EngAdriano/Aquabox_Final/hardware/Ideia_PCB.png

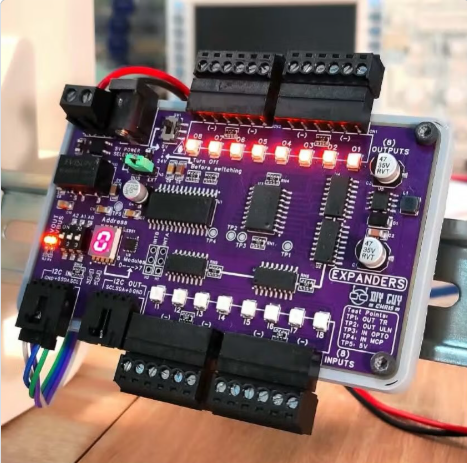
hardware/Ideia_PCB.png
