EngAdriano/Aquabox_Final/exemplos/AcioanamentoRele.jpg

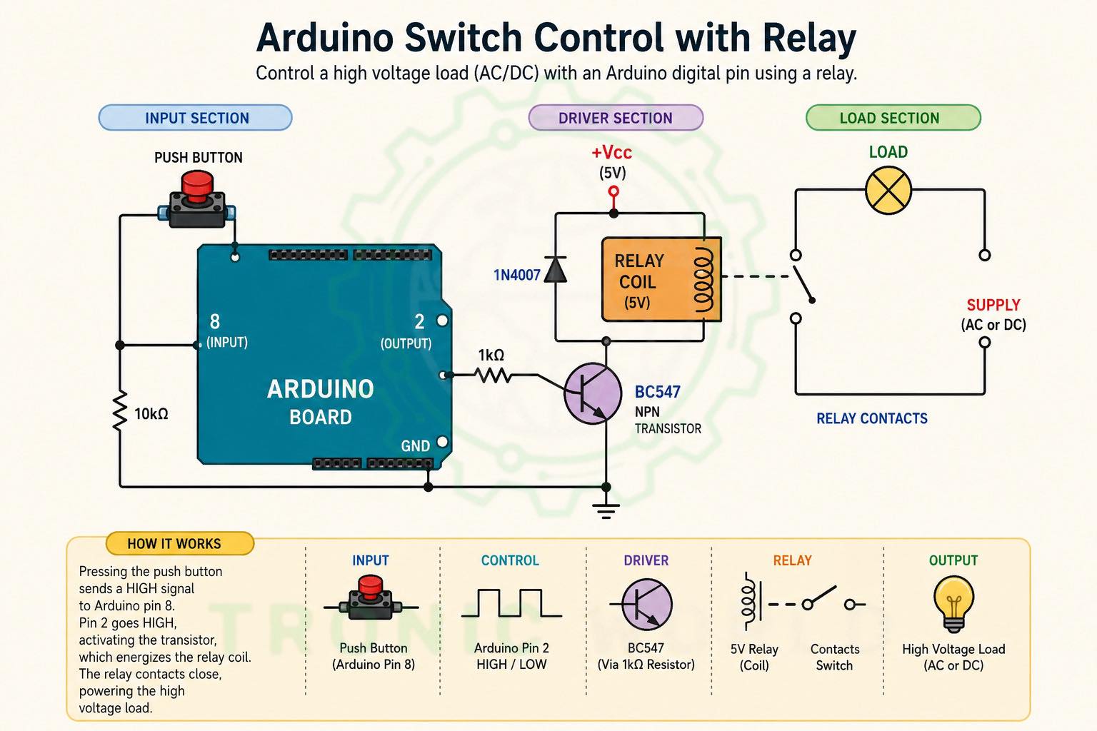
exemplos/AcioanamentoRele.jpg
