EngAdriano/Aquabox_Final/README.md

# Aquabox_Final
Repositório para o desenvolvimento do projeto Aquabox versão final.
