EngAdriano/Aquabox_Final/Planejamento/Respostas_Decisoes_Pendentes.docx

AQUABOX

Planejamento de Requisitos do Firmware

12. Decisões pendentes para a próxima revisão - Respostas:

12.1 - Definir características elétricas e lógica ativa dos sensores de nível, chaves, relé e drivers de solenoide (ativo alto/baixo, pull-up/pull-down e isolamento).

R. Planilha com todos os dados necessários:

12.2 - Definir limites configuráveis: duração máxima de irrigação, timeout de enchimento, janela de atraso, debounce e faixas da vazão esperada.

R.

- Duração máxima de irrigação: 60 minutos por setor (solenoide);
- Timeout de enchimento: 10 minutos;
- Janela de atraso: 5 minutos entre setores;
- Debounce: implementado em hardware;
- Faixa de vazão esperada: configurada pois depende da rede hidráulica.

12.3 - Confirmar se a irrigação terá dias da semana, múltiplos horários por canal e regras para pular ciclos em caso de falta de água.

R. A Irrigação poderá ser configurada se será ativa por dia da semana, poderá ser configurado para pelo menos dois horários do dia por canal, em caso de falta de água alertar e esperar a normalização para ser acionada.

12.4 - Definir comportamento da chave de bomba independente: somente solicitação manual com válvula aberta ou operação de teste com regra adicional.

R. A Chave da bomba será utilizada para acionamento da mesma em caso de necessidade de água para outras atividades. Não será necessário acionamento de válvula solenoide pois terá uma conexão própria para tal atividade.

12.5 - Definir retenção de configuração e de histórico, além da necessidade de bateria no RTC e política para horário inválido.

R.: As configurações deverão ser armazenadas em memória para não serem perdidas com falta de energia. O histórico pode ser armazenado em memória que vem com o módulo RTC que será alimentada por uma bateria, assim com falta de energia não perderá o relógio nem o conteúdo da memória AT24C32 que vem nele.

12.6 - Definir broker MQTT, política de credenciais, uso obrigatório de TLS, certificado de autoridade e processo de provisionamento Wi-Fi.

R. Vamos utilizar o broker HiveMQ, vamos criar credenciais para cada Aquabox que for instalado. Inicialmente teremos dois.

12.7 - Definir permissões de comando remoto por perfil/usuário, retenção de telemetria e integração prevista com painel ou aplicativo.

R. Gostaria que você definisse a melhor política para esses casos.

12.8 - Definir orçamento de CPU, tamanho de pilha, prioridades e afinidade definitiva de cada tarefa FreeRTOS após prototipação com Wi-Fi e display reais.

R. Foi montado um protótipo para acompanhar o desenvolvimento do firmware, ele está baseado na planilha do item 12.1, assim vamos evoluir de acordo com os testes e necessidade. A nossa CPU será a ESP32-S3 DevKitC-1 8MB PSRAM 16MB FLASH N16R8 Dual type-C 44P.

12.9 - Validar requisitos de proteção elétrica, caixa, grau de proteção ambiental e normas aplicáveis ao conjunto.

R. Ao concluirmos o firmware no protótipo, passaremos para a etapa de desenvolvimento da placa PCB e todos os detalhes para a montagem em caixa própria e proteções, se bem que o sistema já vai contar com várias proteções como fontes isoladas, optoacopladores com alimentações isoladas, entre outras.

Documento de trabalho - Firmware Aquabox

AQUABOX | PLANEJAMENTO DE REQUISITOS
