EngAdriano/Aquabox_Final/firmware/Pinagem_ESP32_S3.pdf

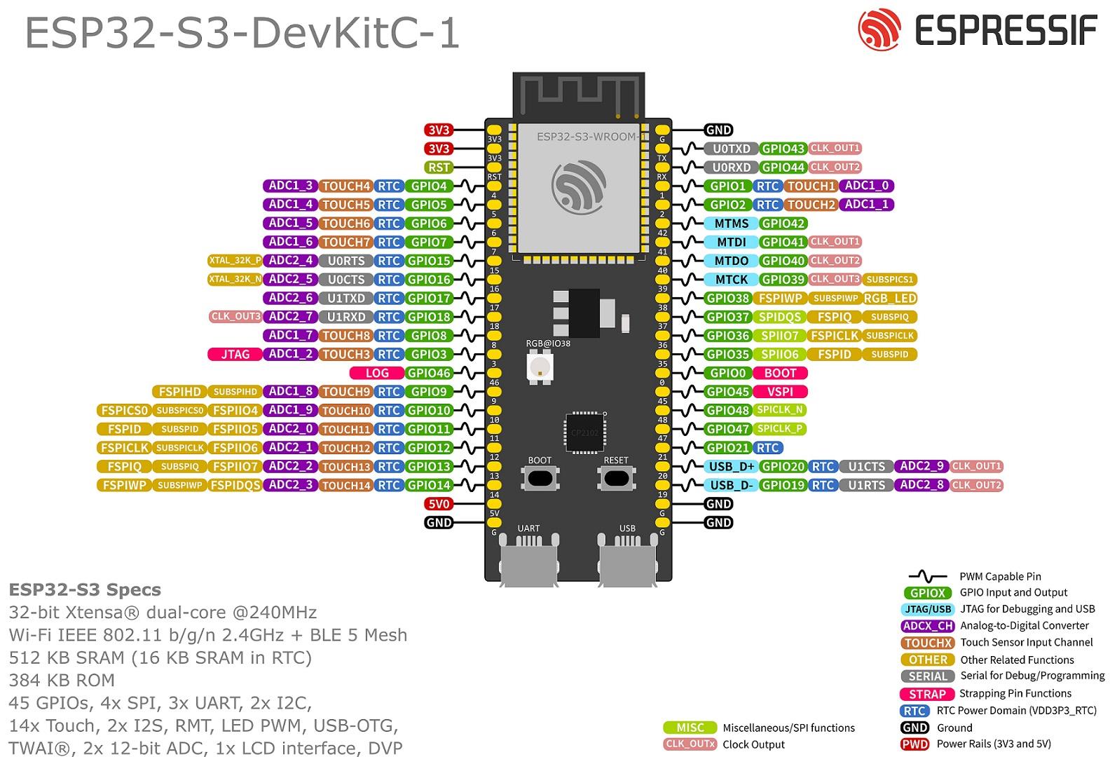
[picture p3: page 1]
