EngAdriano/Aquabox_Final/hardware/Lista_de_Componentes.pdf

Reference | Qty Value | Footprint
BT1 | 1 | Battery_Cell | Battery:Battery_Panasonic_CR2032-HFN_Horizontal_CircularHoles
C1 | 1 | 0.1uFx275V
C2 | 1 | 220uF
C3,C4,C5,C6,C7,C8,C9,C10,C11 | 9 | 100n
D1,D2 | 2 | RED
D3,D4,D5,D6,D7,D8,D9,D10 | 8 | LED
D11 | 1 | 1N4007 | Diode_THT:D_DO-41_SOD81_P10.16mm_Horizontal
F1 | 1 | 1A 250V
J1 | 1 | Entrada de 12V
J2 | 1 | AC 220V
J3 | 1 | Caixa_1
J4 | 1 | Caixa_2
J5 | 1 | Caixa_3
J6 | 1 | Sensor de Fluxo
J7 | 1 | Screw_Terminal_01x04
J8 | 1 | Conn_01x03
J9 | 1 | Conn_01x05
J10 | 1 | Conn_01x10
K1 | 1 | Relay_SPDT
PS1 | 1 | MC00100 | MC00100:CONV_MC00100
Q1,Q3,Q5,Q10 | 4 | BC337 | Package_TO_SOT_THT:TO-92_Inline
Q2,Q4,Q6 | 3 | BC327 | Package_TO_SOT_THT:TO-92_Inline
Q7,Q8,Q9 | 3 | IRLZ44N | Package_TO_SOT_THT:TO-220-3_Vertical
R1,R7,R8,R9,R10,R13,R14,R15,R16,R19,R20,R21,R22,R23,R28,R29,R30,R41 | 18 1K
R2 | 1 | 1M
R3,R25,R40,R42 | 4 | 220R
R4,R5,R6 | 3 | 4K7
R11,R12,R17,R18,R24,R26,R27,R31,R32,R33,R37,R38,R39,R43,R44,R45,R46,R47,R48,R49,R50,R51,R52,R53,R54 | 25 10K
R34,R35,R36 | 3 | 10R
RV1 | 1 | 10D561K
U1 | 1 | HLK-10M05 | Converter_ACDC:Converter_ACDC_Hi-Link_HLK-10Mxx
U2 | 1 | ESP32-S3-DEVKITC-1-N16R8V | ESP32-S3-DEVKITC-1-N16R8V:XCVR_ESP32-S3-DEVKITC-1-N16R8V
U3 | 1 | DS3231M | Package_SO:SOIC-16W_7.5x10.3mm_P1.27mm
U4,U5,U6,U7,U8,U9,U10,U11,U12,U13,U14 | 11 PC817 | Package_DIP:DIP-4_W7.62mm
U15 | 1 | 74HC14
