EngAdriano/Aquabox_Final/modelos/Conect_2_10/Conect_2x10.step

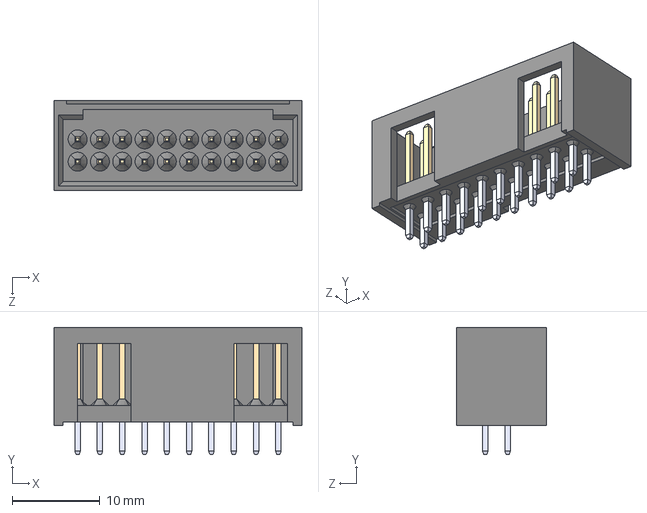
[picture p4: CAD file, 2026-06-03]
modelos/Conect_2_10/Conect_2x10.step
28.2 x 14.5 x 10.3 mm
