EngAdriano/Aquabox_Final/modelos/ESP32-S3-DEVKITC-1-N16R8V/ESP32-S3-DEVKITC-1-N16R8V.step

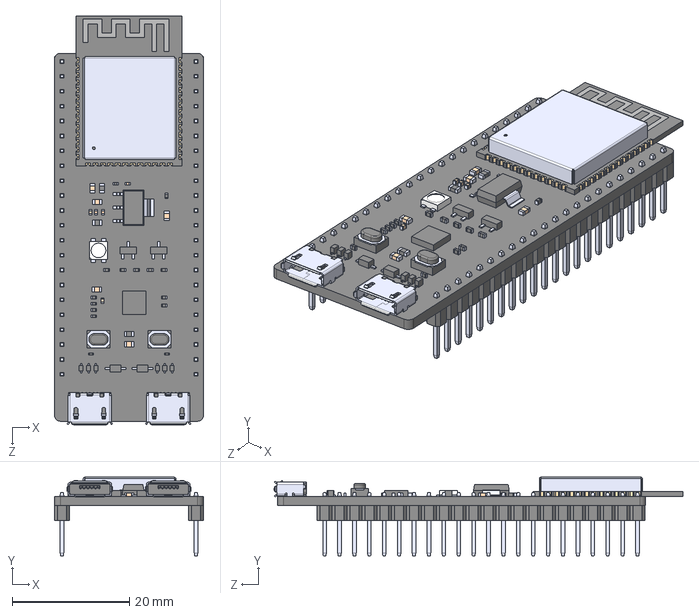
[picture p5: CAD file, 2026-05-29]
modelos/ESP32-S3-DEVKITC-1-N16R8V/ESP32-S3-DEVKITC-1-N16R8V.step
25.4 x 13.4 x 69.6 mm
