EngAdriano/Aquabox_Final/modelos/Conect_2x5/5104338-1.step

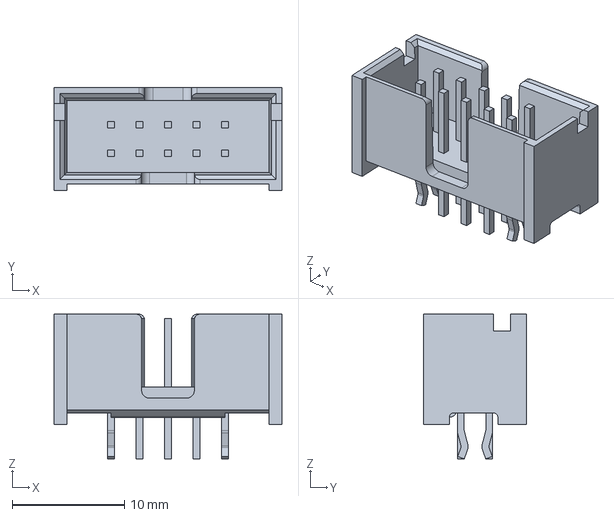
[picture p6: CAD file, 2026-06-03]
modelos/Conect_2x5/5104338-1.step
20.3 x 9.14 x 12.9 mm
