EngAdriano/Aquabox_Final/modelos/MC00100/MC00100.step

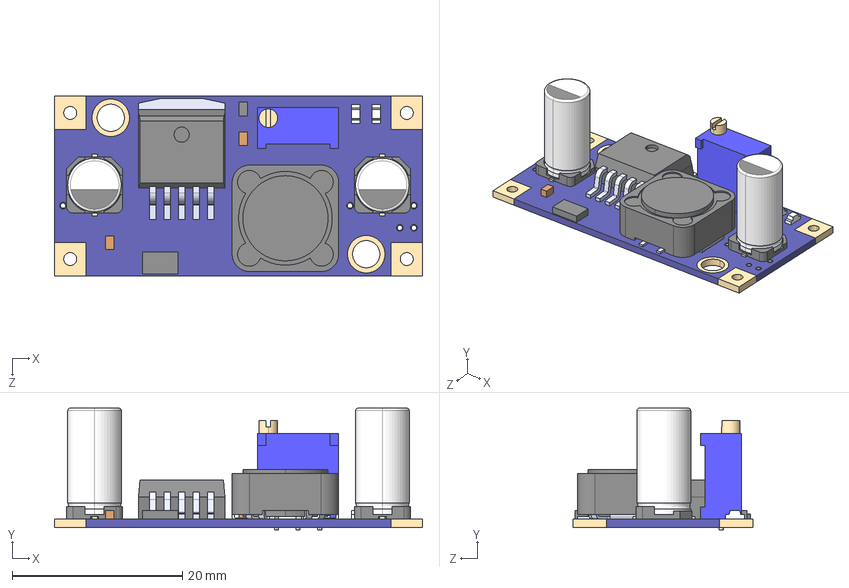
[picture p7: CAD file, 2026-06-02]
modelos/MC00100/MC00100.step
43.2 x 14.3 x 21.1 mm
MC00100
3296W-1-104
DR125-331-R
LM2596DSADJG
EEE1HA470XAP x 2
