EngAdriano/Aquabox_Final/exemplos/Acitivity-Tracker-Schematic.pdf

` | `

# Battery Charger

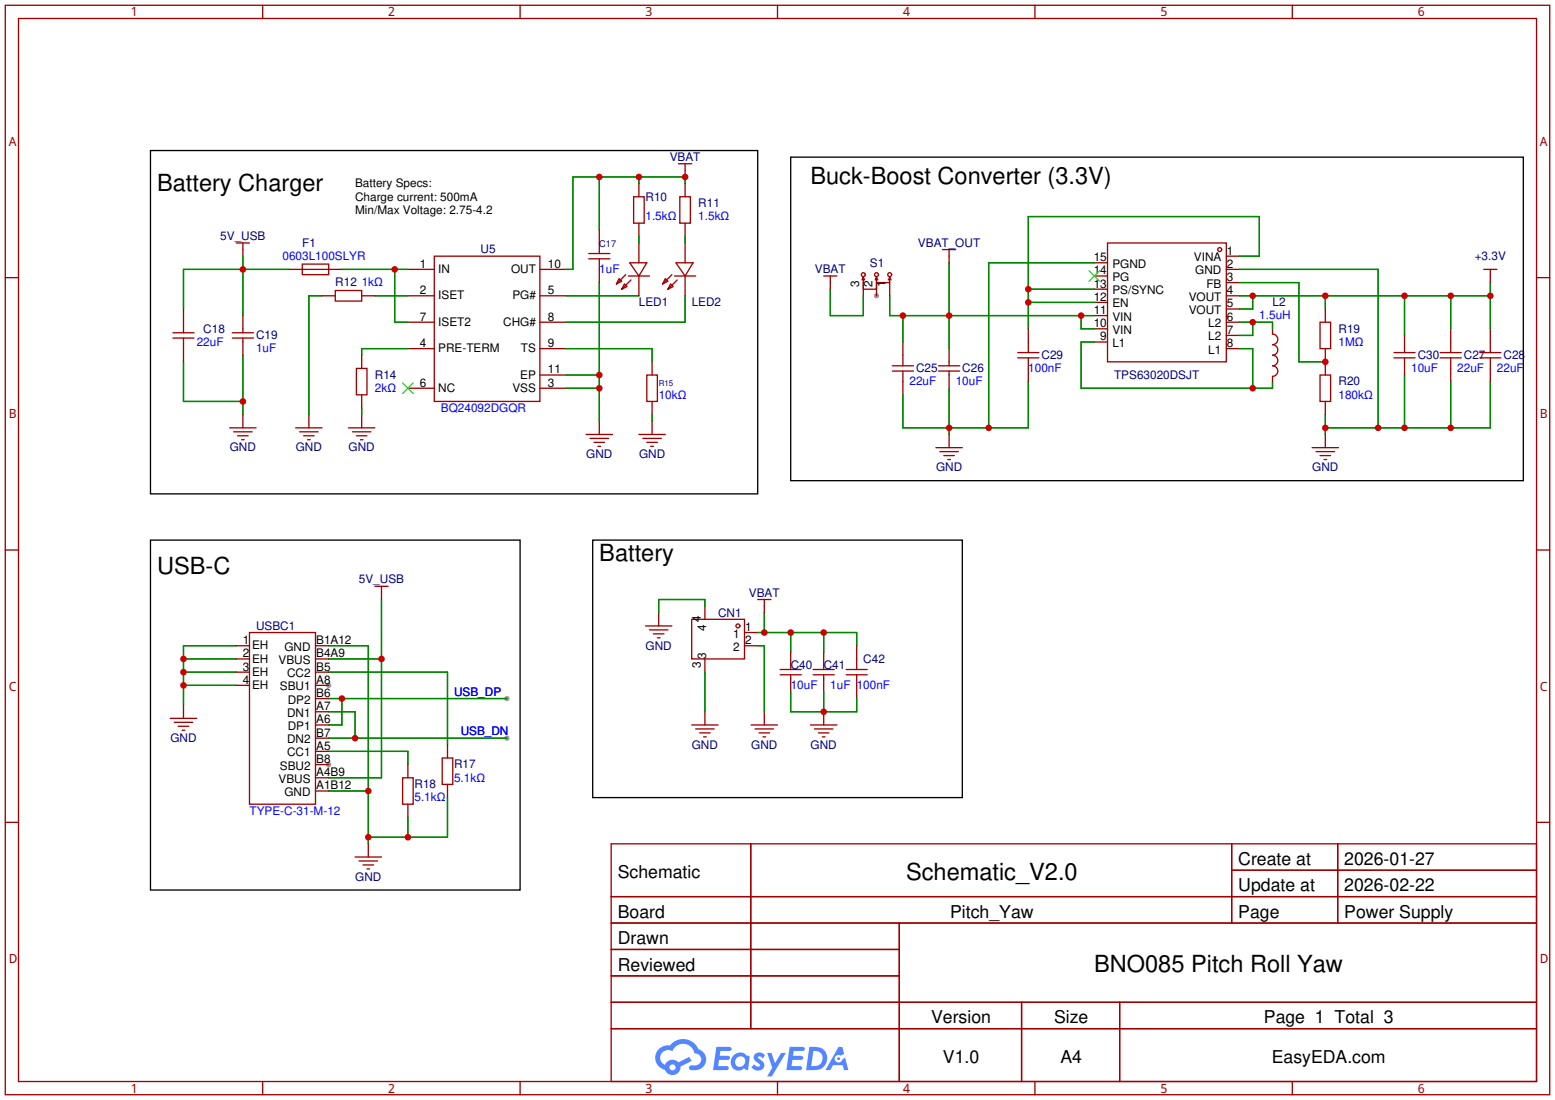
[picture p8: page 1]

VIN 10 VIN 11 EN 12 PS/SYNC 13 PG 14 PGND 15

USB-C
GND A1B12 VBUS A4B9 SBU2 B8 CC1 A5 DN2 B7 DP1 A6 DN1 A7 DP2 B6 SBU1 A8 CC2 B5 VBUS B4A9 GND B1A12

Schematic | Schematic_V2.0 | Create at | 2026-01-27

Update at | 2026-02-22

Board | Pitch_Yaw | Page | Power Supply
Drawn | | BNO085 Pitch Roll Yaw
Reviewed

Version | Size | Page 1 Total 3

V1.0 | A4 | EasyEDA.com

` | `
IO0 27 IO35 28 IO36 29 IO37 30 IO38 31 IO39 32 IO40 33 IO41 34 IO42 35 RXD0 36 TXD0 37 IO2 38 IO1 39 GND 40

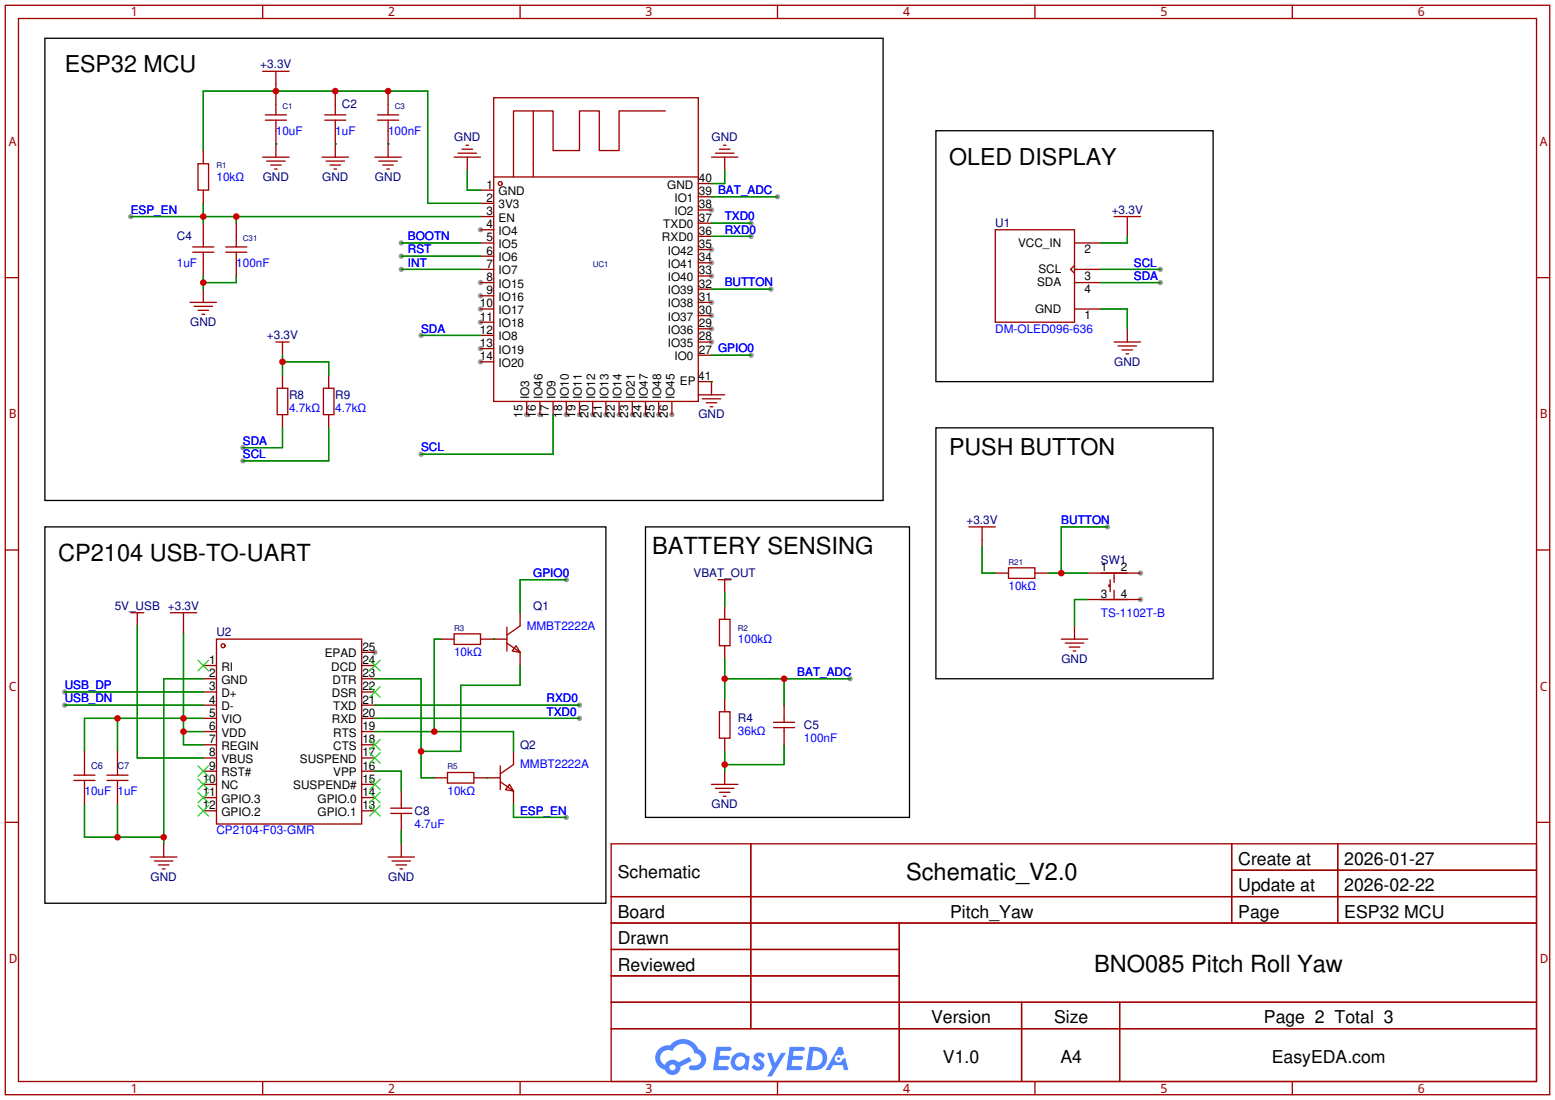
[picture p9: page 2]

Schematic | Schematic_V2.0 | Create at | 2026-01-27

Update at | 2026-02-22

Board | Pitch_Yaw | Page | ESP32 MCU
Drawn | | BNO085 Pitch Roll Yaw
Reviewed

` | `

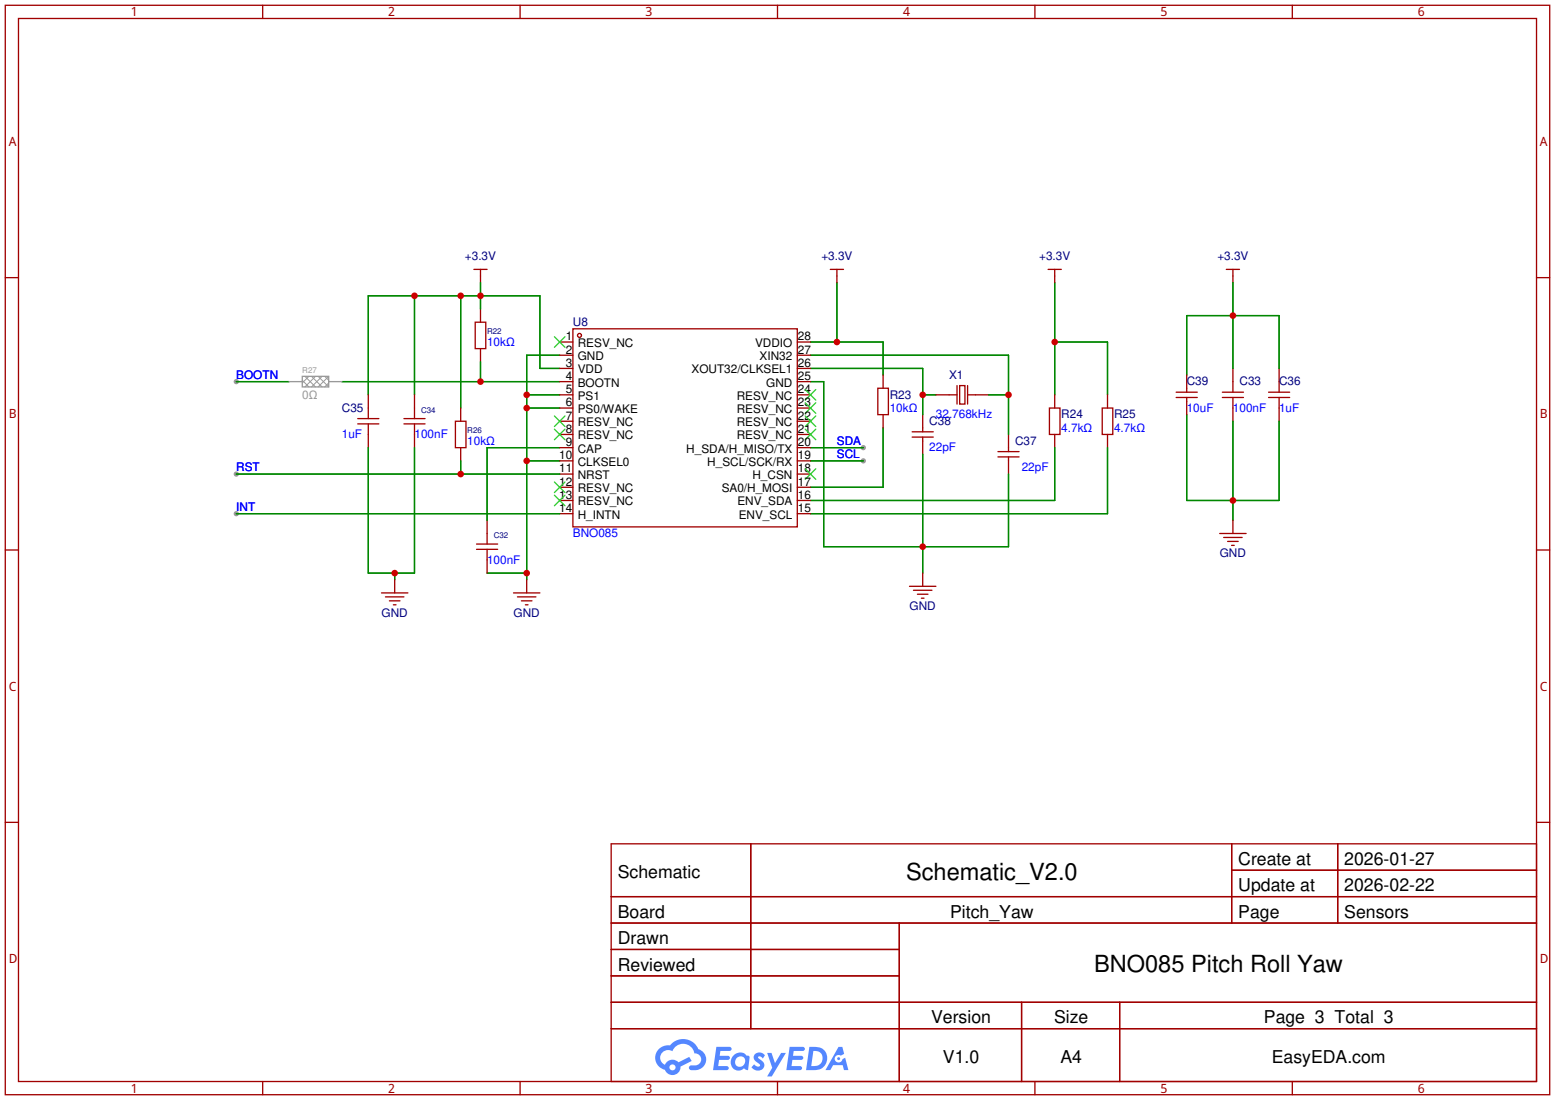
[picture p10: page 3]

Schematic | Schematic_V2.0 | Create at | 2026-01-27

Update at | 2026-02-22

Board | Pitch_Yaw | Page | Sensors
Drawn | | BNO085 Pitch Roll Yaw
Reviewed
