EngAdriano/Aquabox_Final/hardware/aquabox_final/aquabox_final.pdf

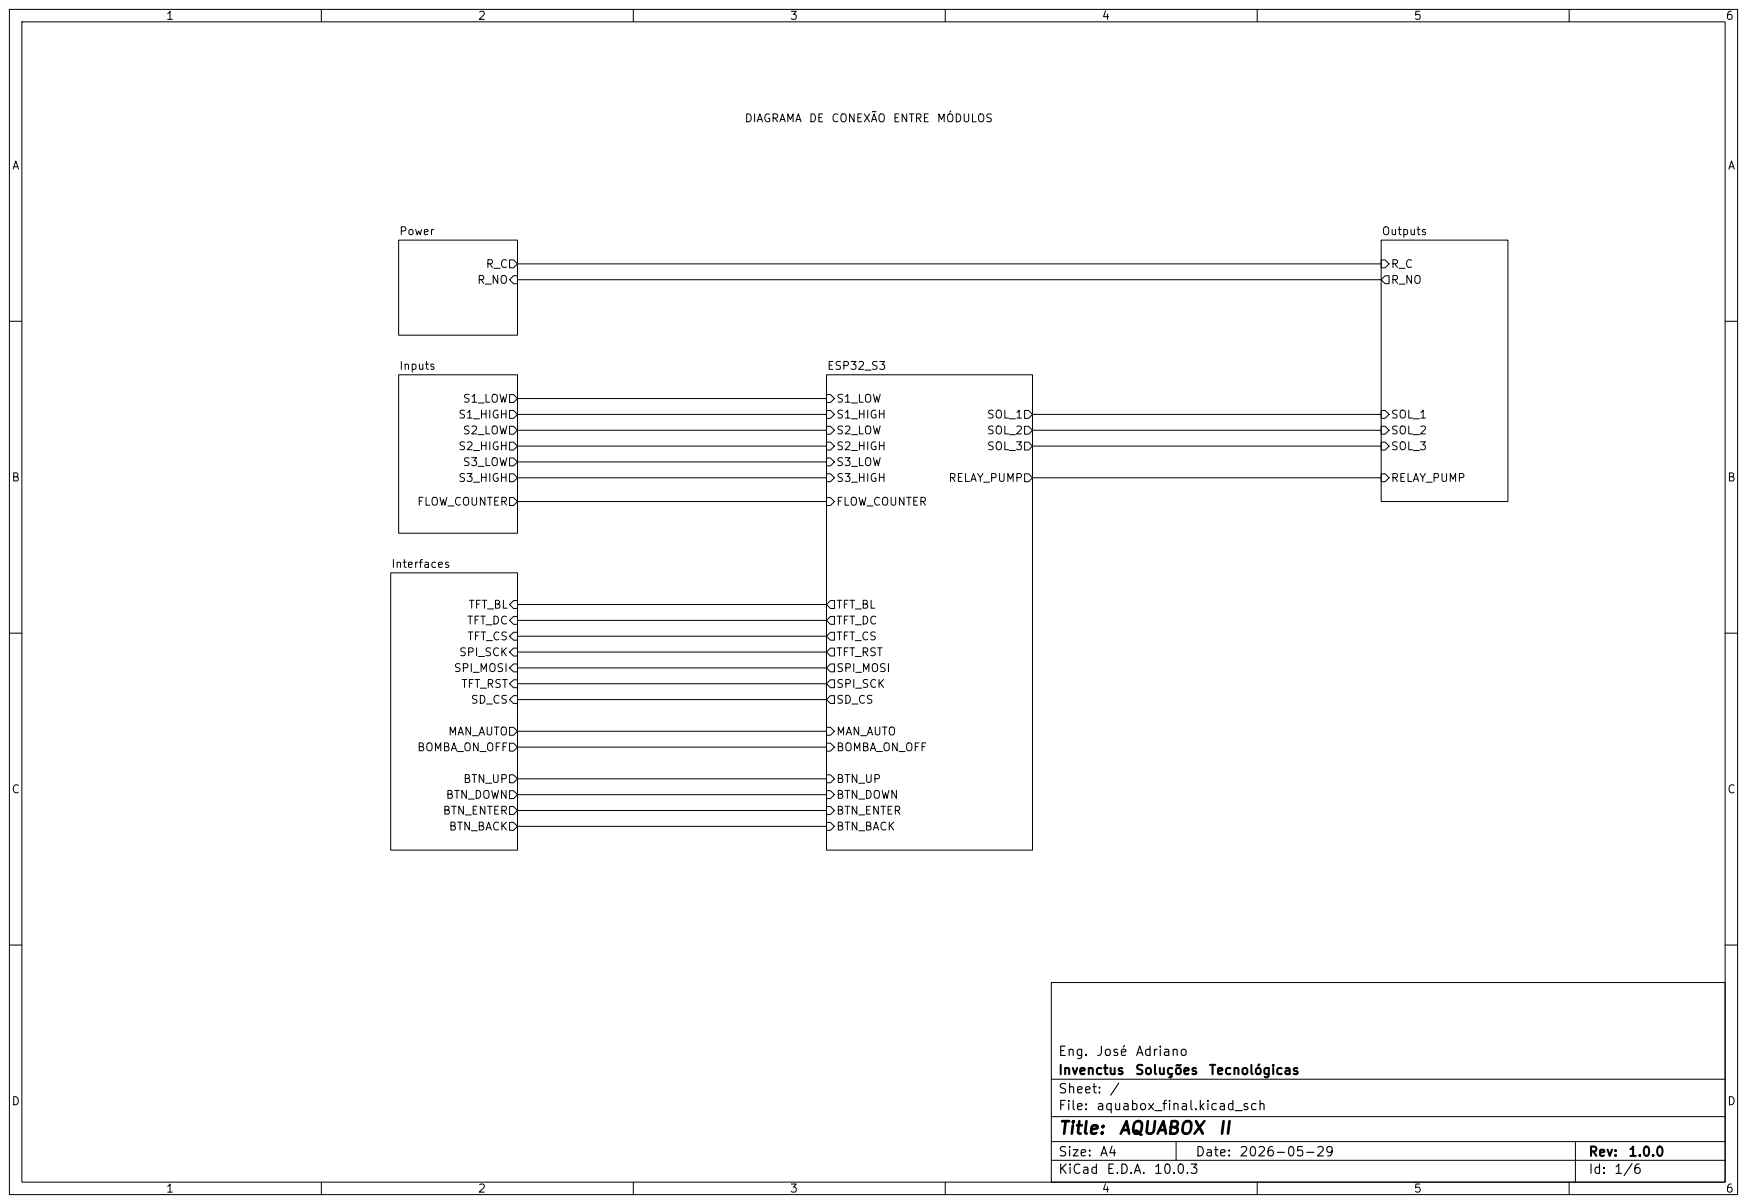
[picture p11: page 1]

SOL_1 Outputs DIAGRAMA DE CONEXÃO ENTRE MÓDULOS

Size: A4 | Rev: 1.0.0
KiCad E.D.A. 10.0.3 | Id: 1/6

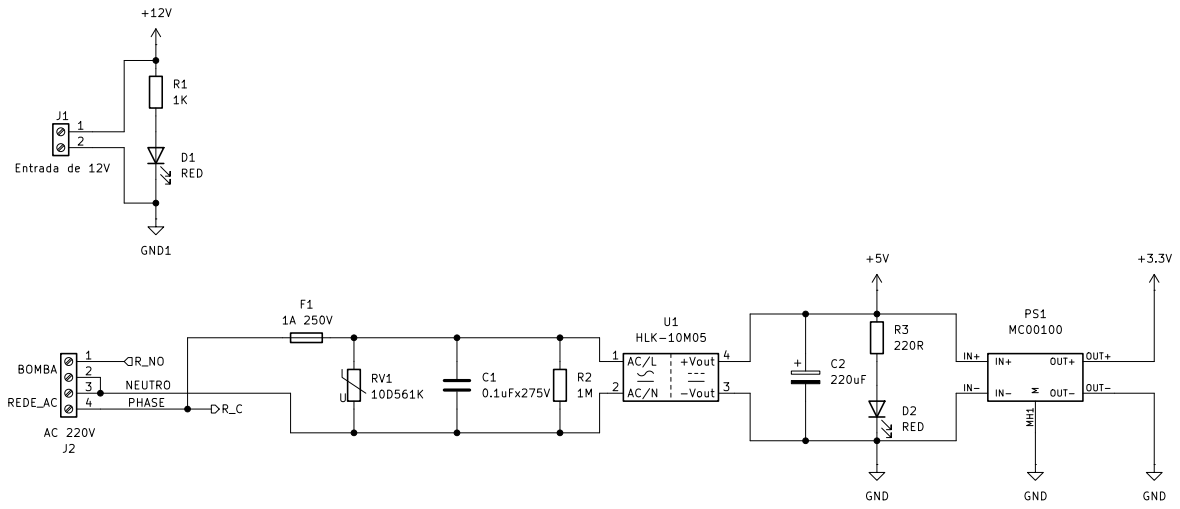
[picture p12: page 2]

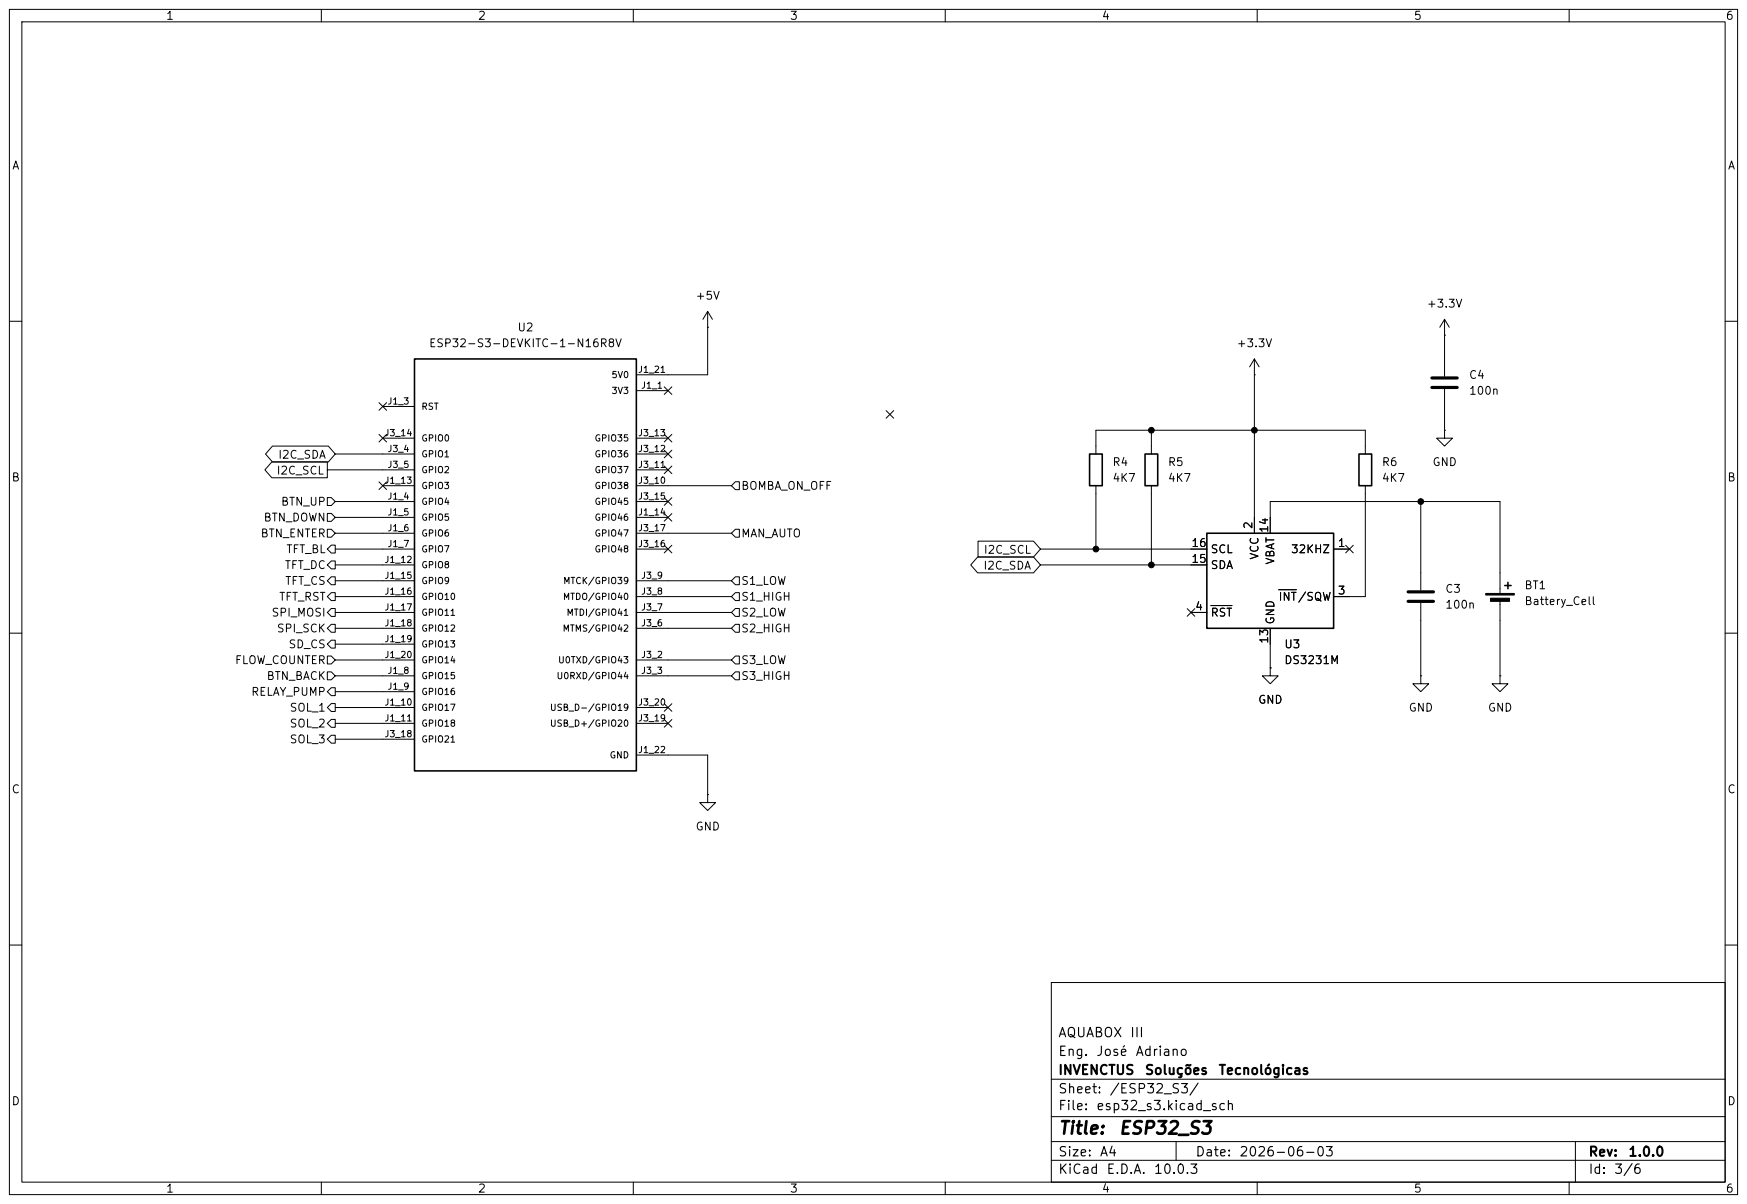
[picture p13: page 3]

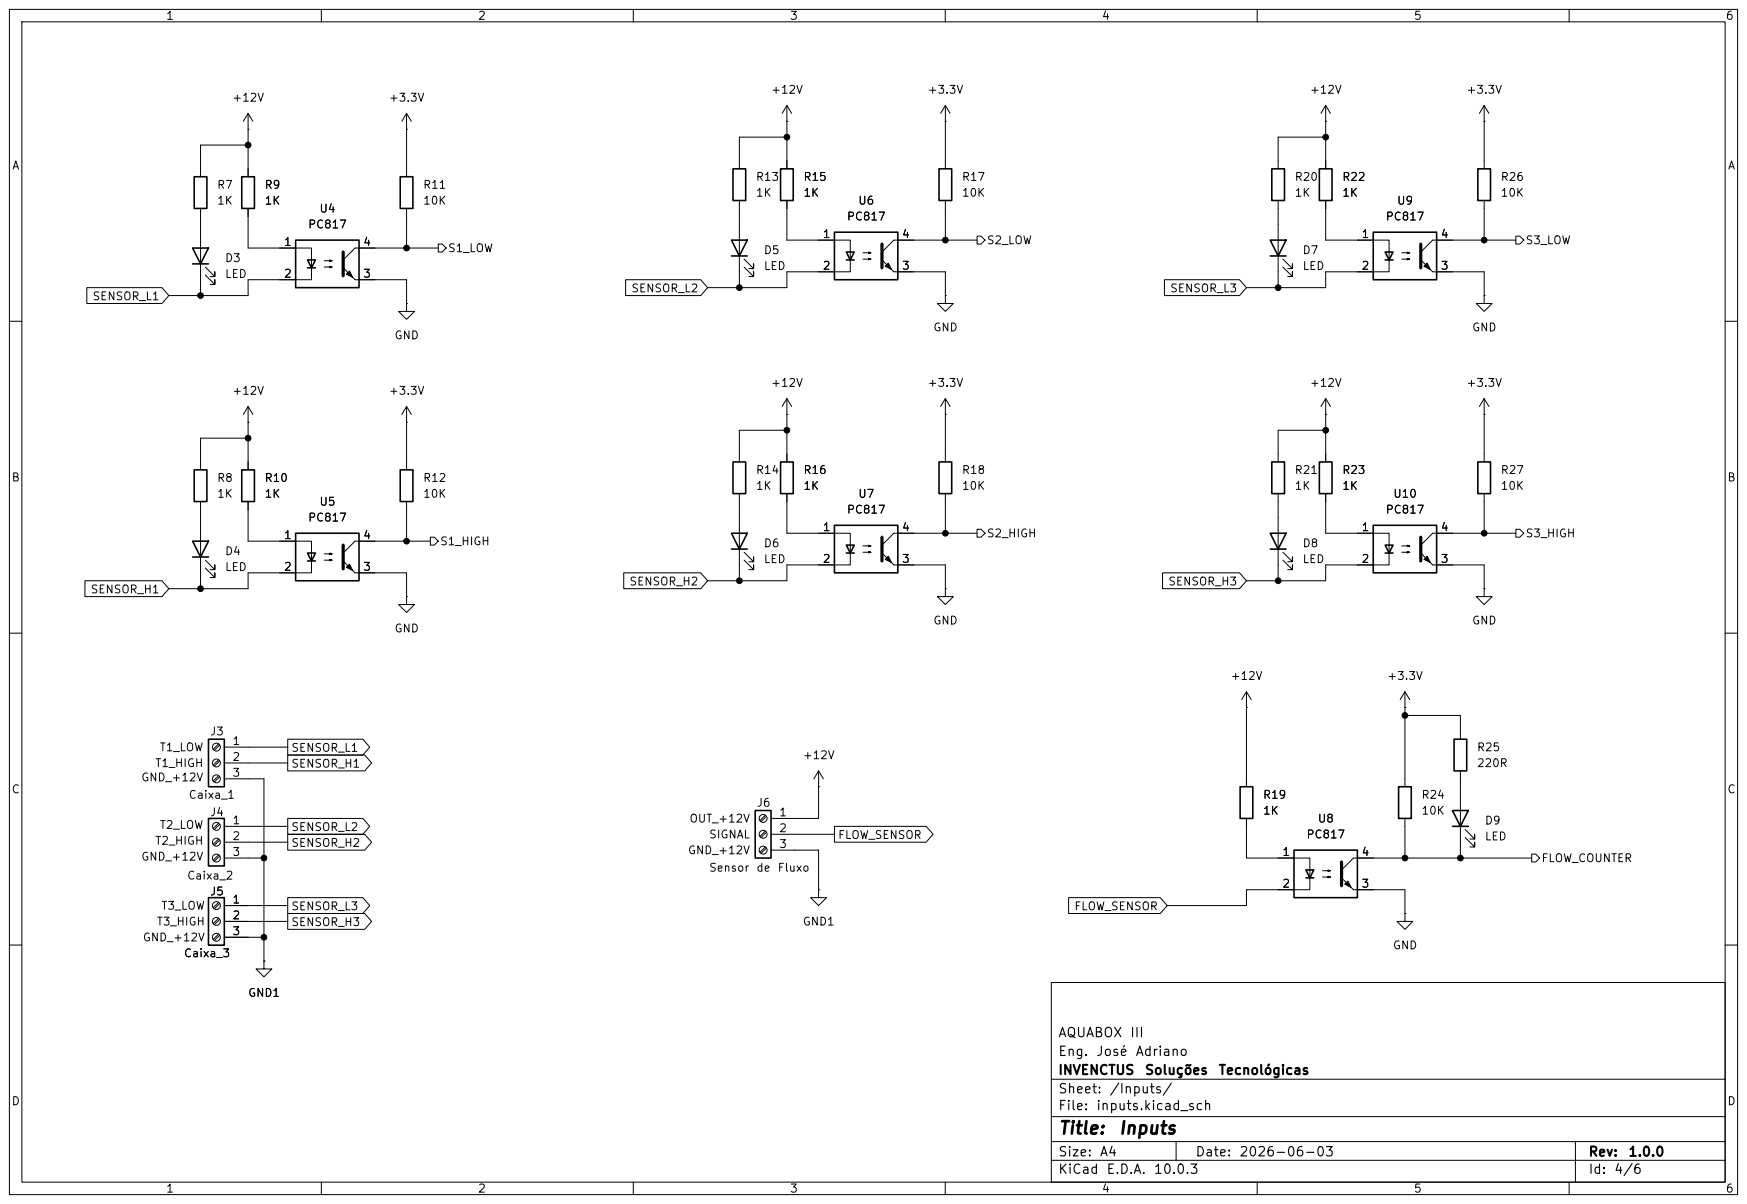
[picture p14: page 4]

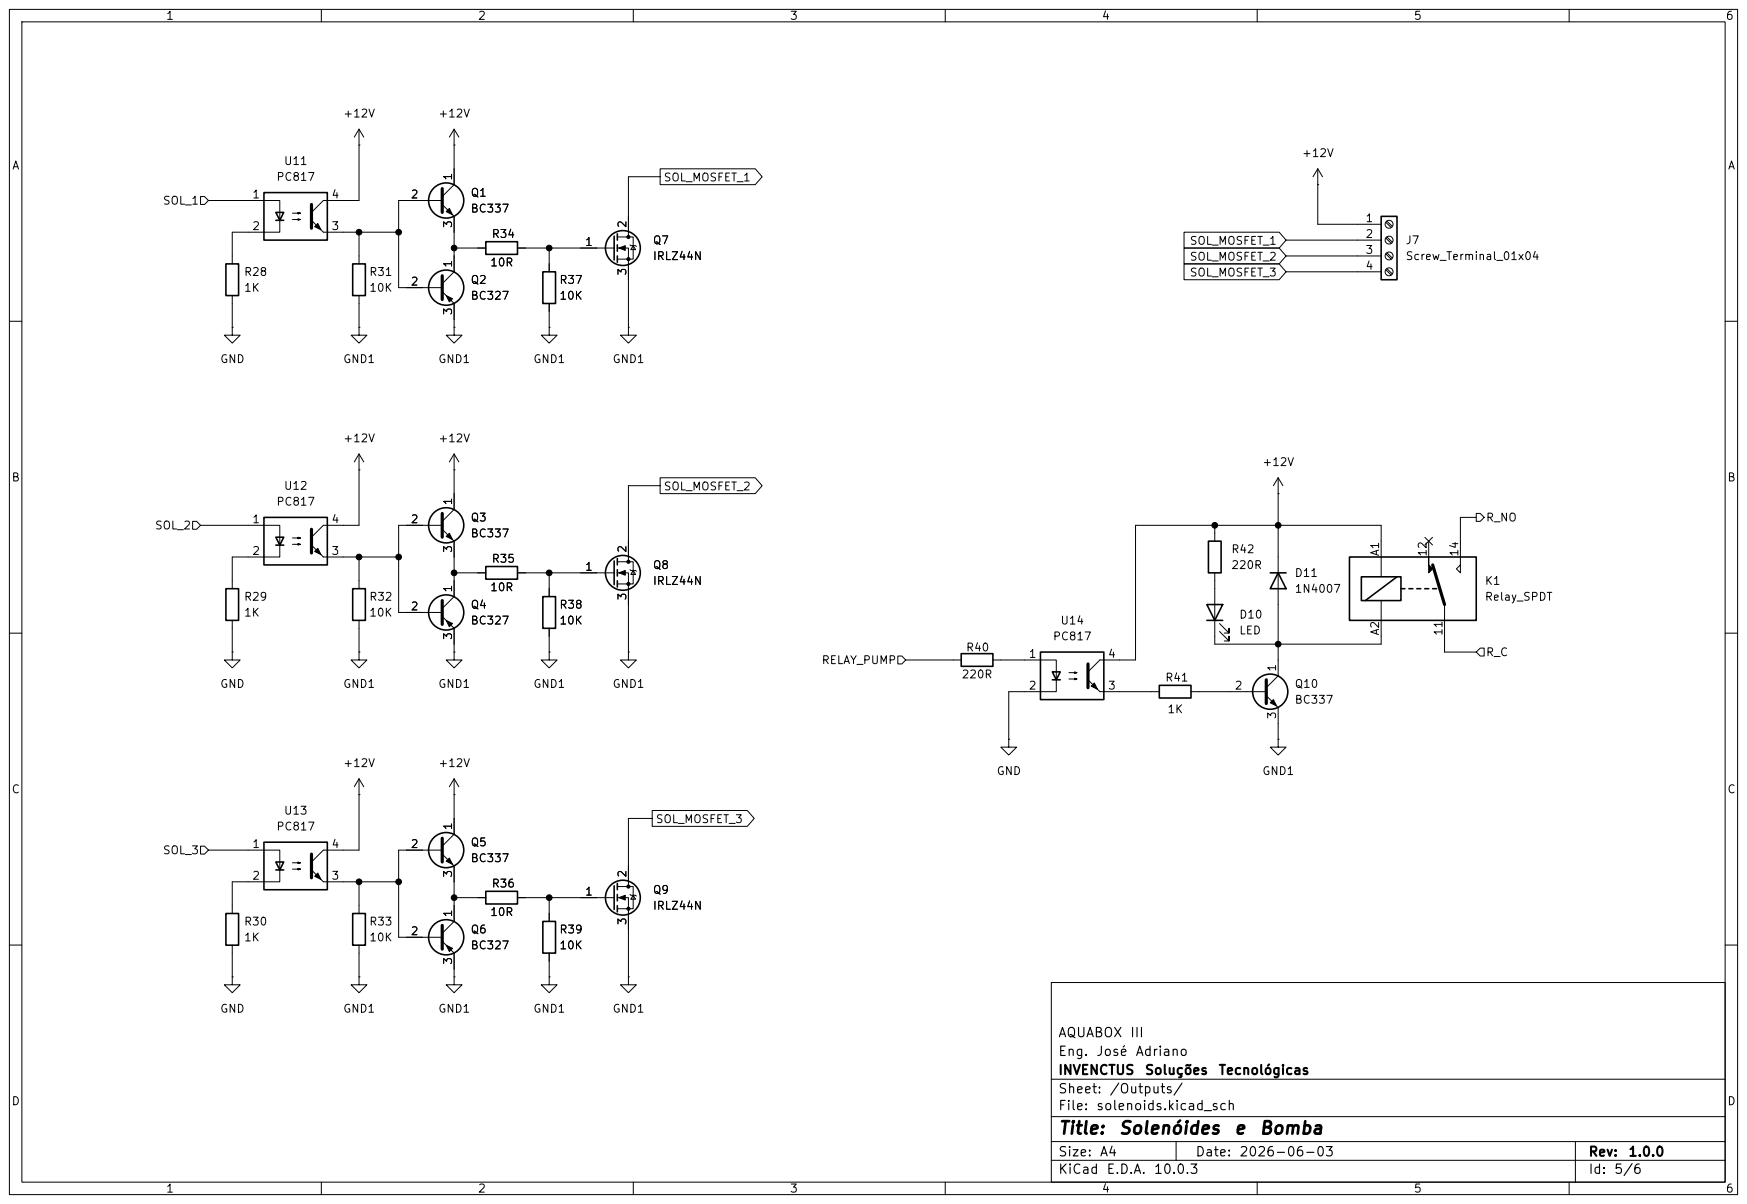
[picture p15: page 5]

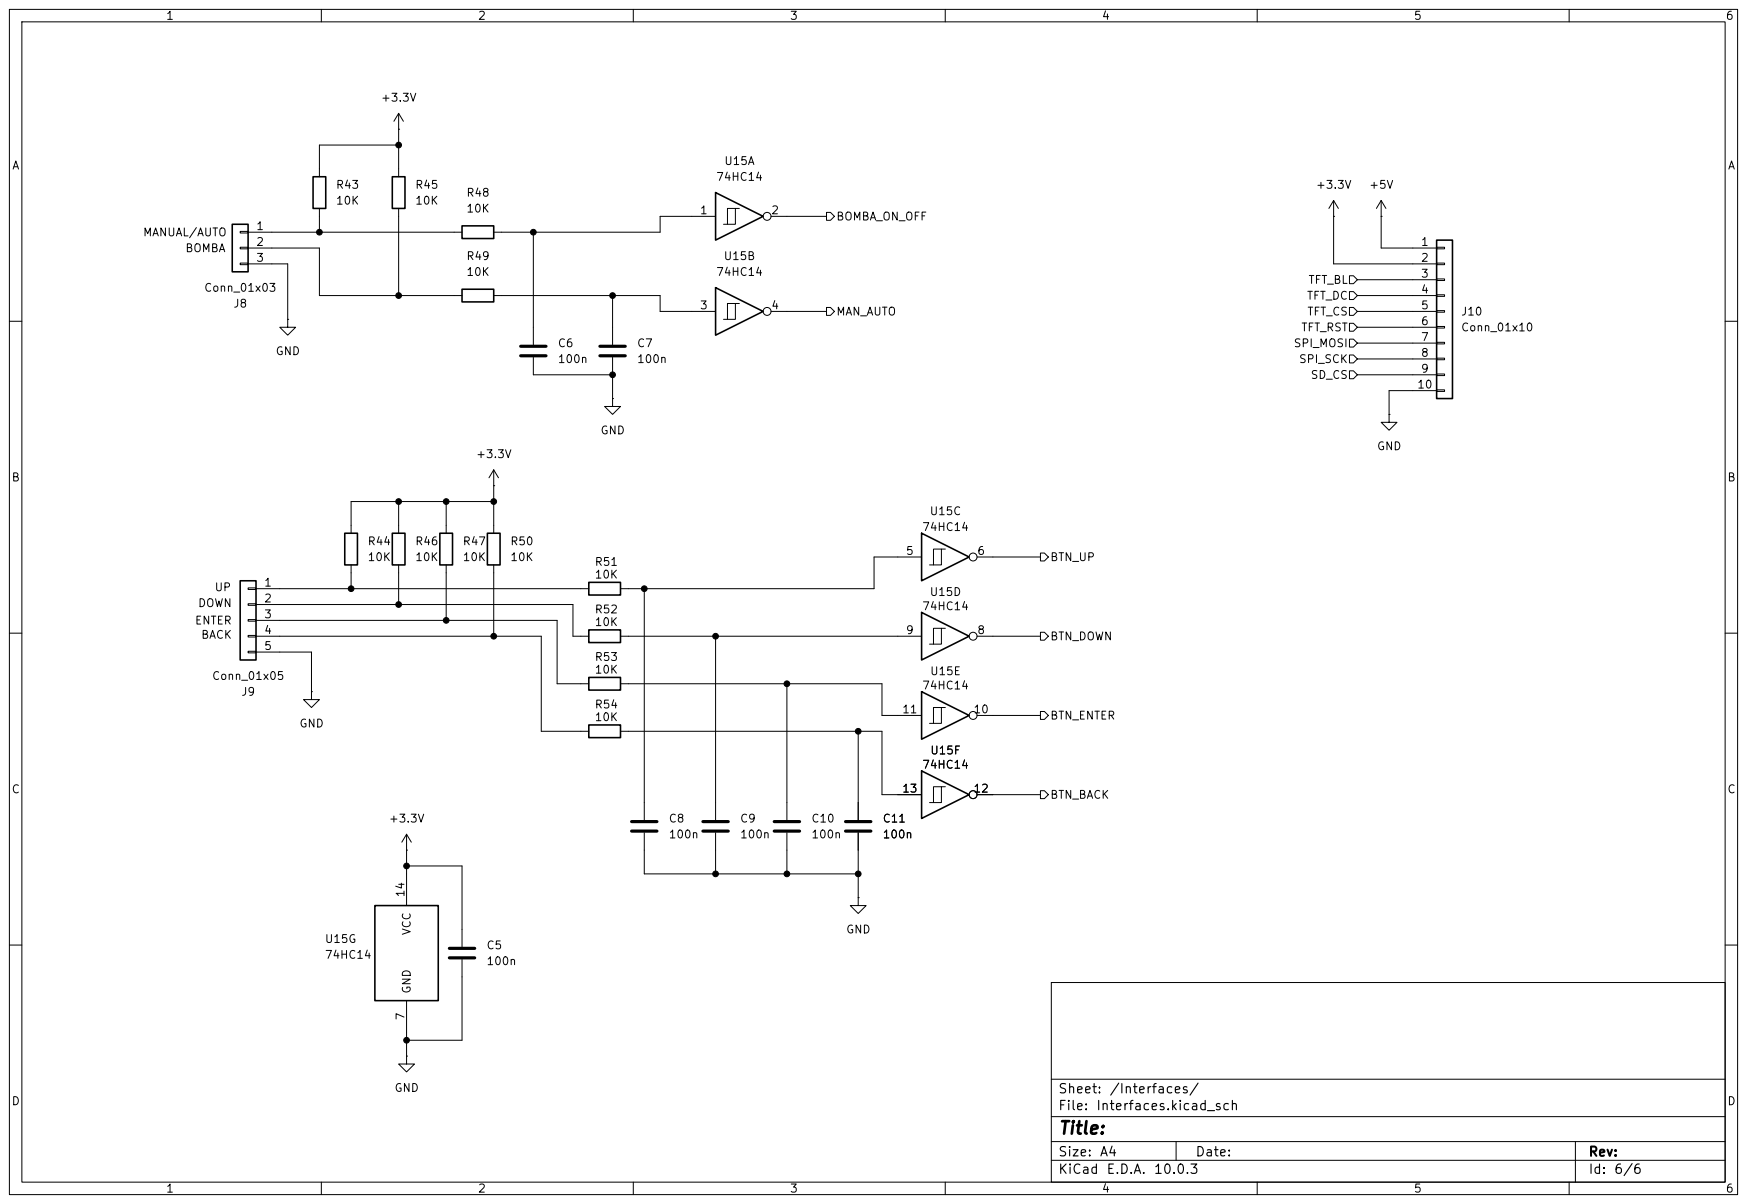
[picture p16: page 6]
