EngAdriano/Aquabox_Final/firmware/Pinagem_Espressif_ESP32_S3.pdf

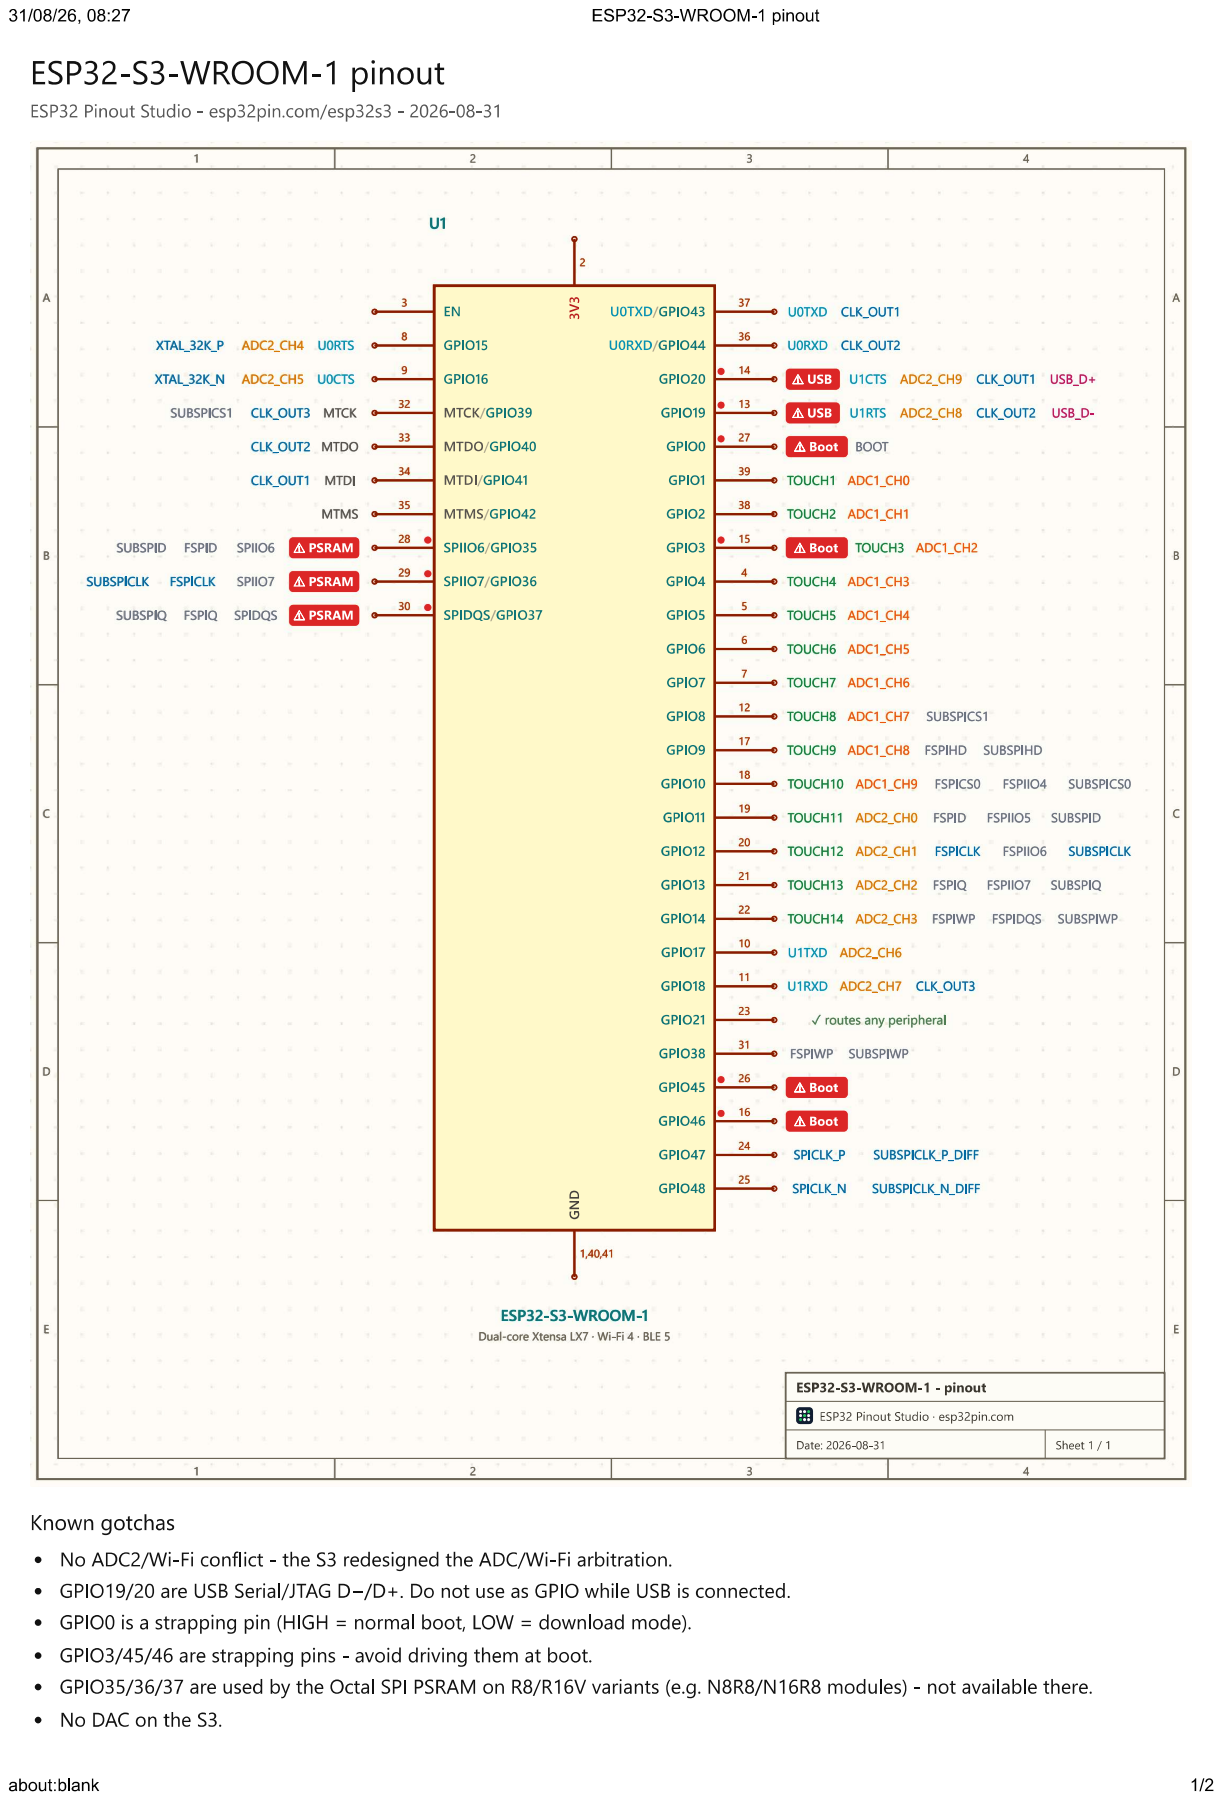
[picture p17: page 1]

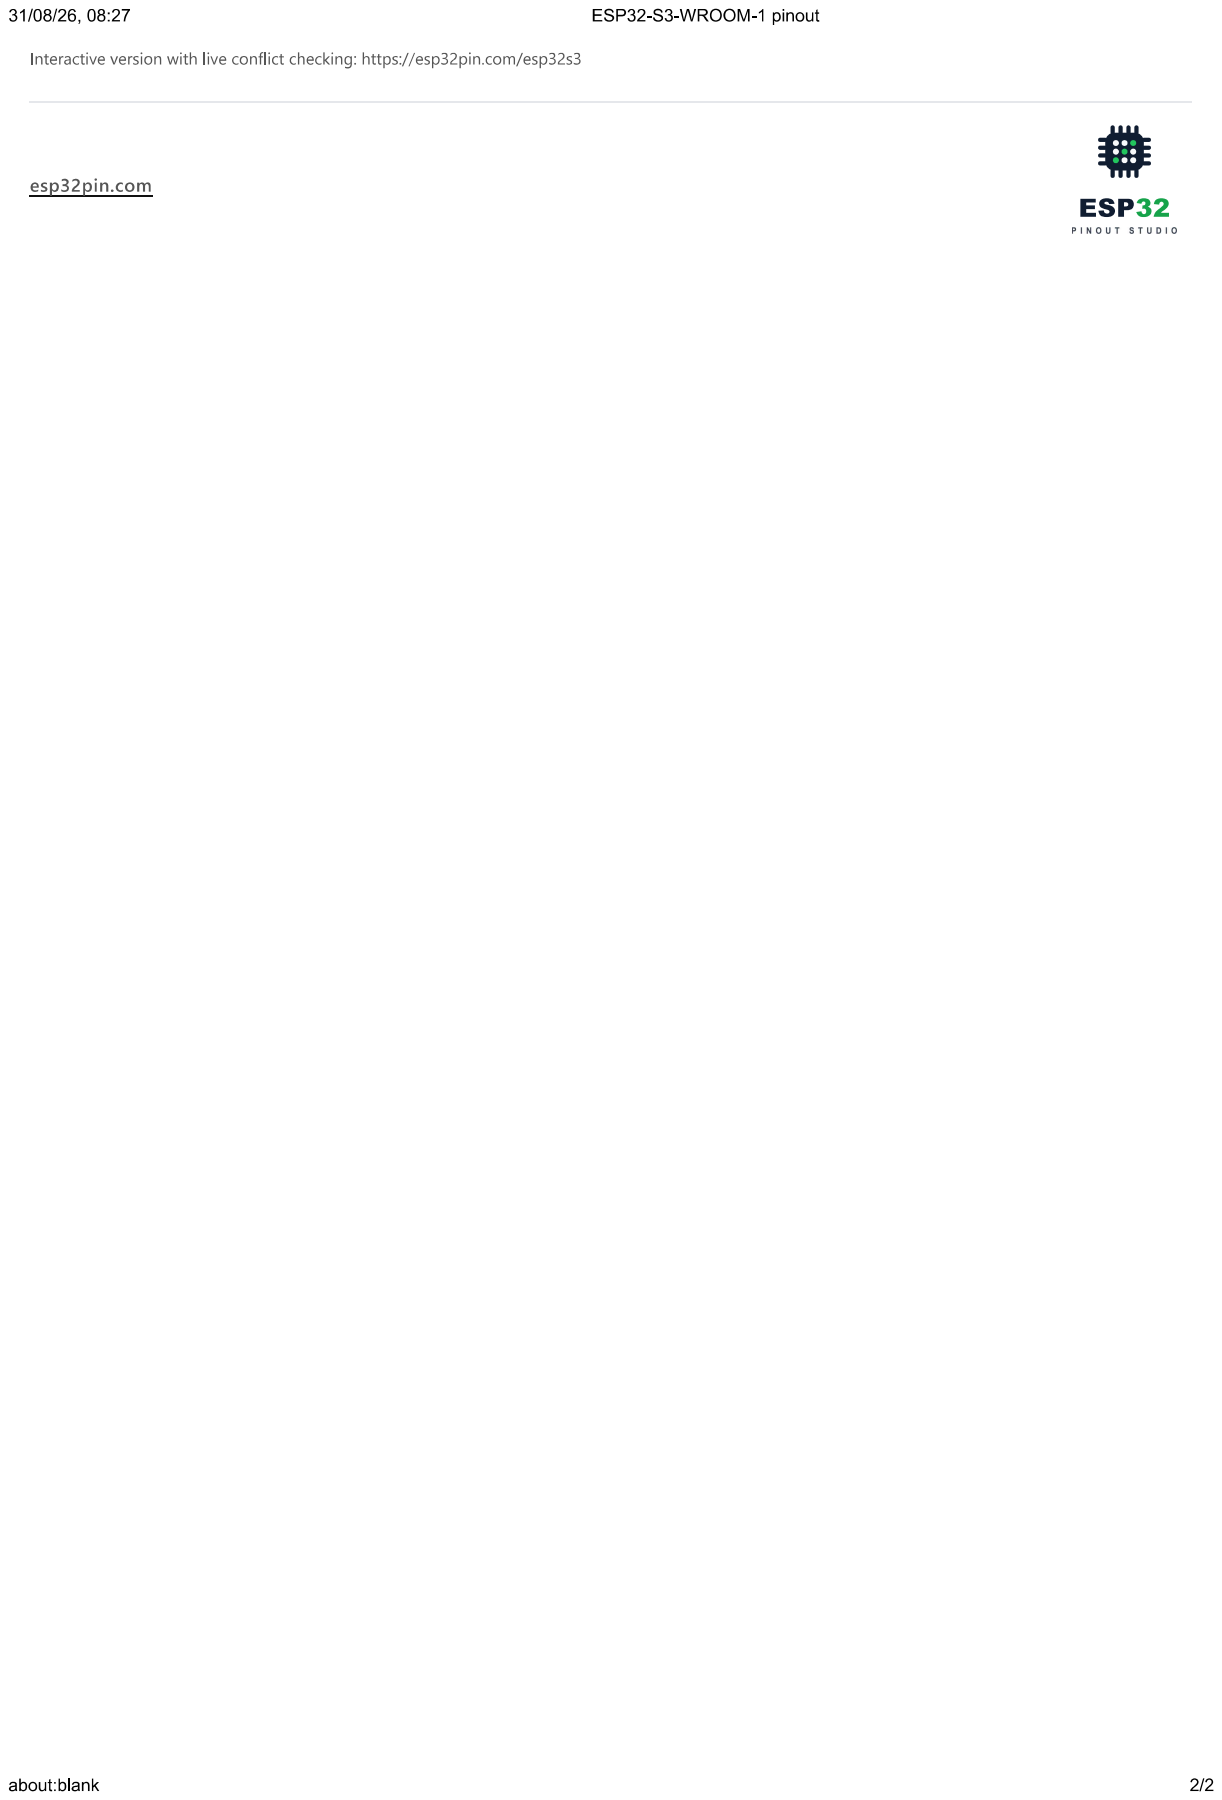
[picture p18: page 2]
