EngAdriano/Aquabox_Final/(list of files, drawings)

Other design files:
exemplos/Project Backups/testeMosfet [20260622, 11-18-56].pdsprj
exemplos/Project Backups/testeMosfet [20260702, 09-51-27].pdsprj
exemplos/Project Backups/testeMosfet [20260702, 09-51-28].pdsprj
exemplos/Project Backups/testeMosfet [20260702, 09-51-29].pdsprj
exemplos/Project Backups/testeMosfet [20260702, 09-55-35].pdsprj
exemplos/Project Backups/testeMosfet [20260702, 09-57-04].pdsprj
exemplos/Project Backups/testeMosfet [20260702, 09-57-44].pdsprj
exemplos/Project Backups/testeMosfet [20260702, 10-01-05].pdsprj
exemplos/Project Backups/testeMosfet [20260702, 10-01-23].pdsprj
exemplos/Project Backups/testeMosfet [20260702, 10-22-22].pdsprj
exemplos/testeMosfet.pdsprj
