EngAdriano/Aquabox_Final/hardware/aquabox_final/aquabox_final.kicad_pcb

## KiCad design bridge.kicad_sch

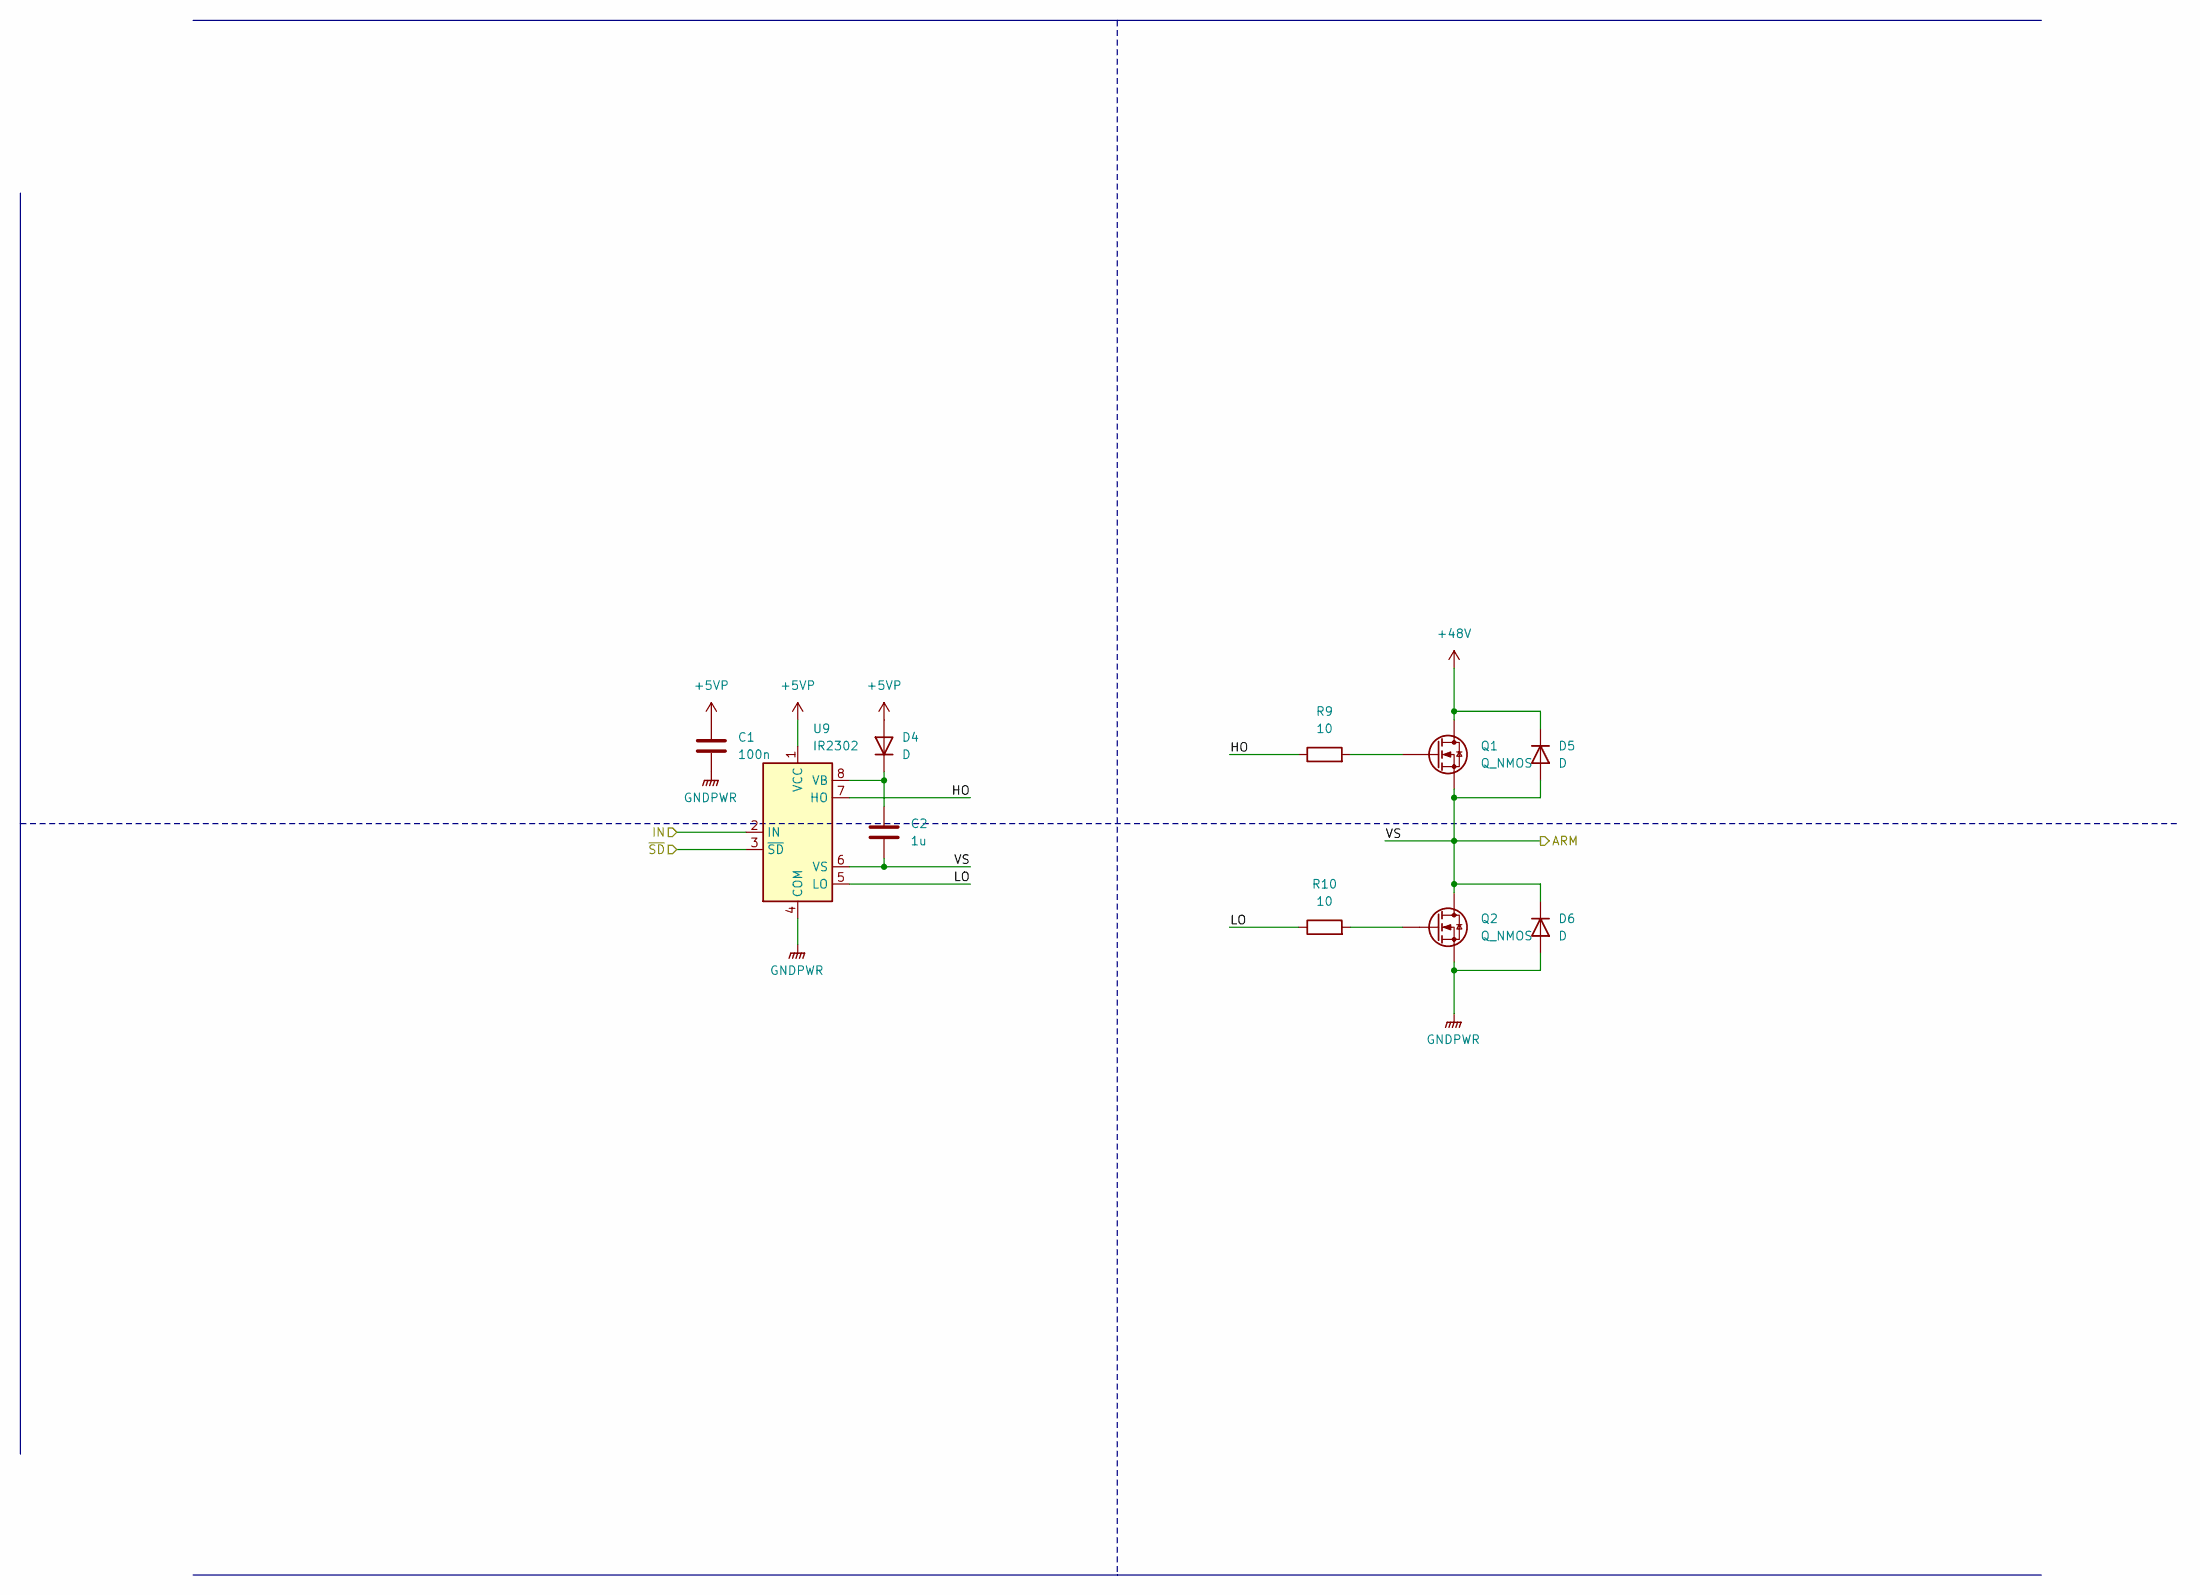
[picture p19: schematic bridge.kicad_sch]

Parts:
C1: 100n
C2: 1u
D4, D5, D6: D
Q1, Q2: Q_NMOS
R9, R10: 10
U9: IR2302

Connections:
+5VP: C1.1, D4.2 (A), U9.1 (VCC)
+48V: D5.1 (K), Q1.D
ARM: C2.2, D5.2 (A), D6.1 (K), Q1.S, Q2.D, U9.6 (VS)
GNDPWR: C1.2, D6.2 (A), Q2.S, U9.4 (COM)
HO: R9.1, U9.7 (HO)
IN: U9.2 (IN)
LO: R10.1, U9.5 (LO)
unnamed: C2.1, D4.1 (K), U9.8 (VB)
unnamed: Q1.G, R9.2
unnamed: Q2.G, R10.2
~SD: U9.3 (~SD)
