EngAdriano/Aquabox_Final/hardware/aquabox_final/aquabox_final.kicad_pcb

## KiCad design isolate.kicad_sch

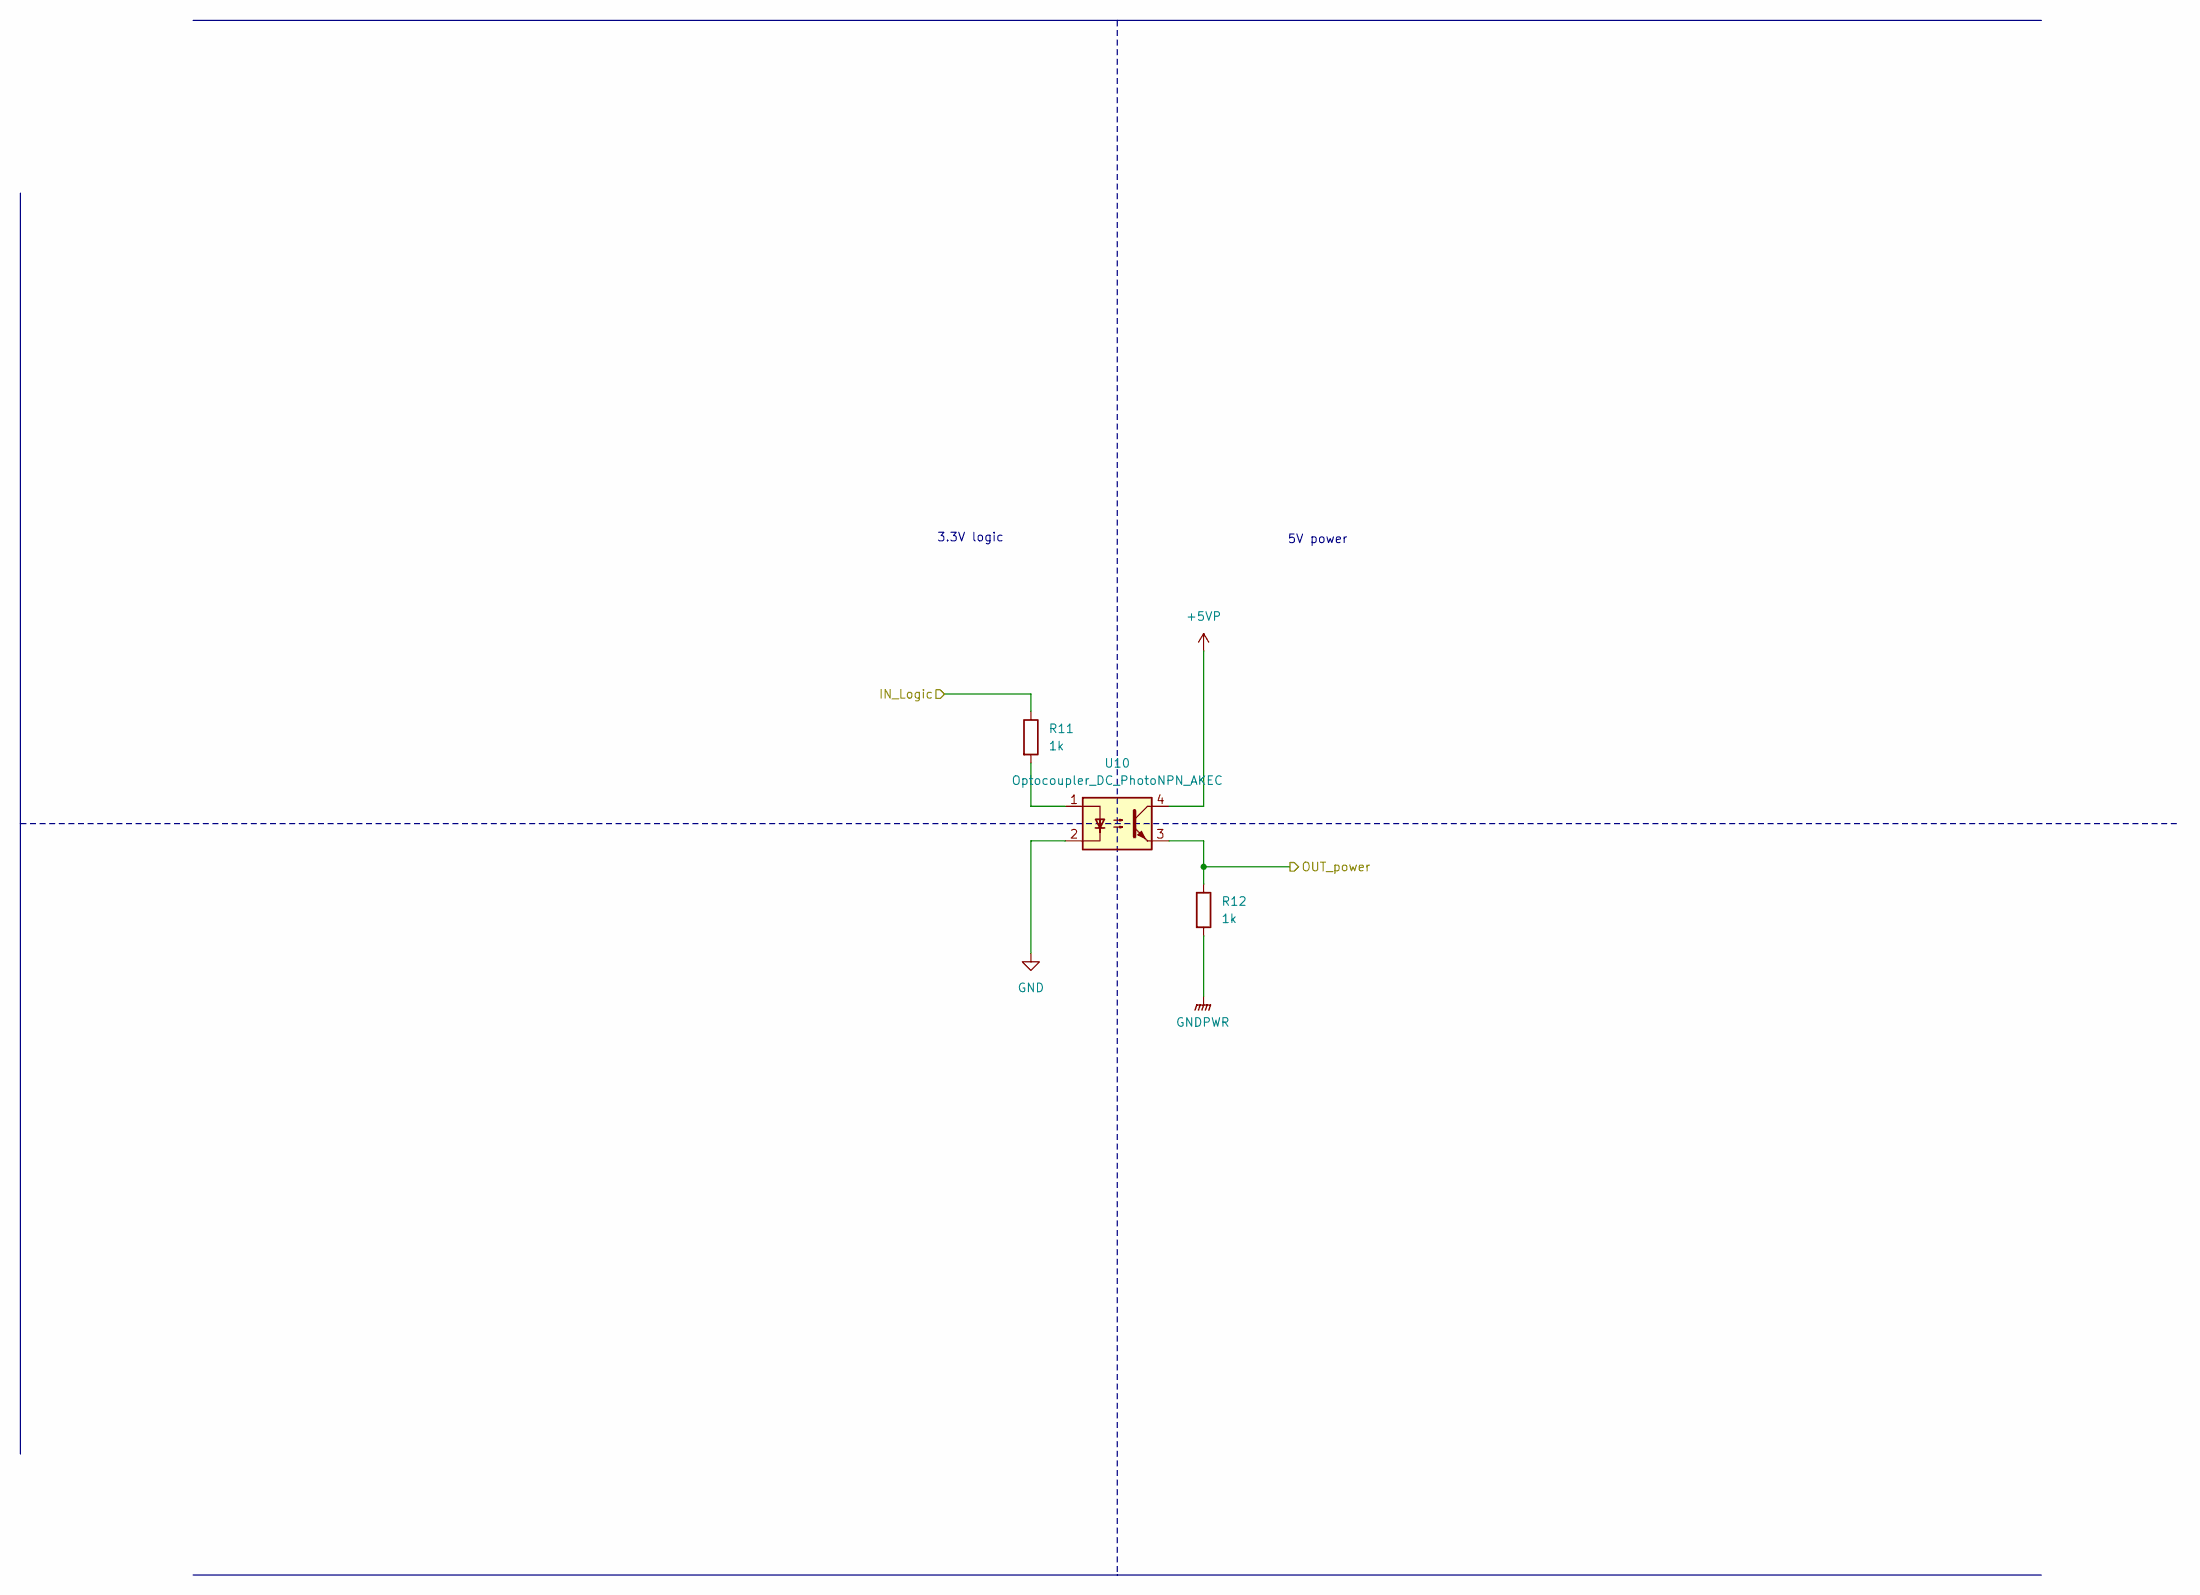
[picture p20: schematic isolate.kicad_sch]

Parts:
R11, R12: 1k
U10: Optocoupler_DC_PhotoNPN_AKEC

Connections:
+5VP: U10.4
GND: U10.2
GNDPWR: R12.2
IN_Logic: R11.1
unnamed: R11.2, U10.1
OUT_power: R12.1, U10.3

Notes on the sheet:
5V power
3.3V logic
