EngAdriano/Aquabox_Final/hardware/aquabox_final/aquabox_final.kicad_pcb

## KiCad design spc500.kicad_sch

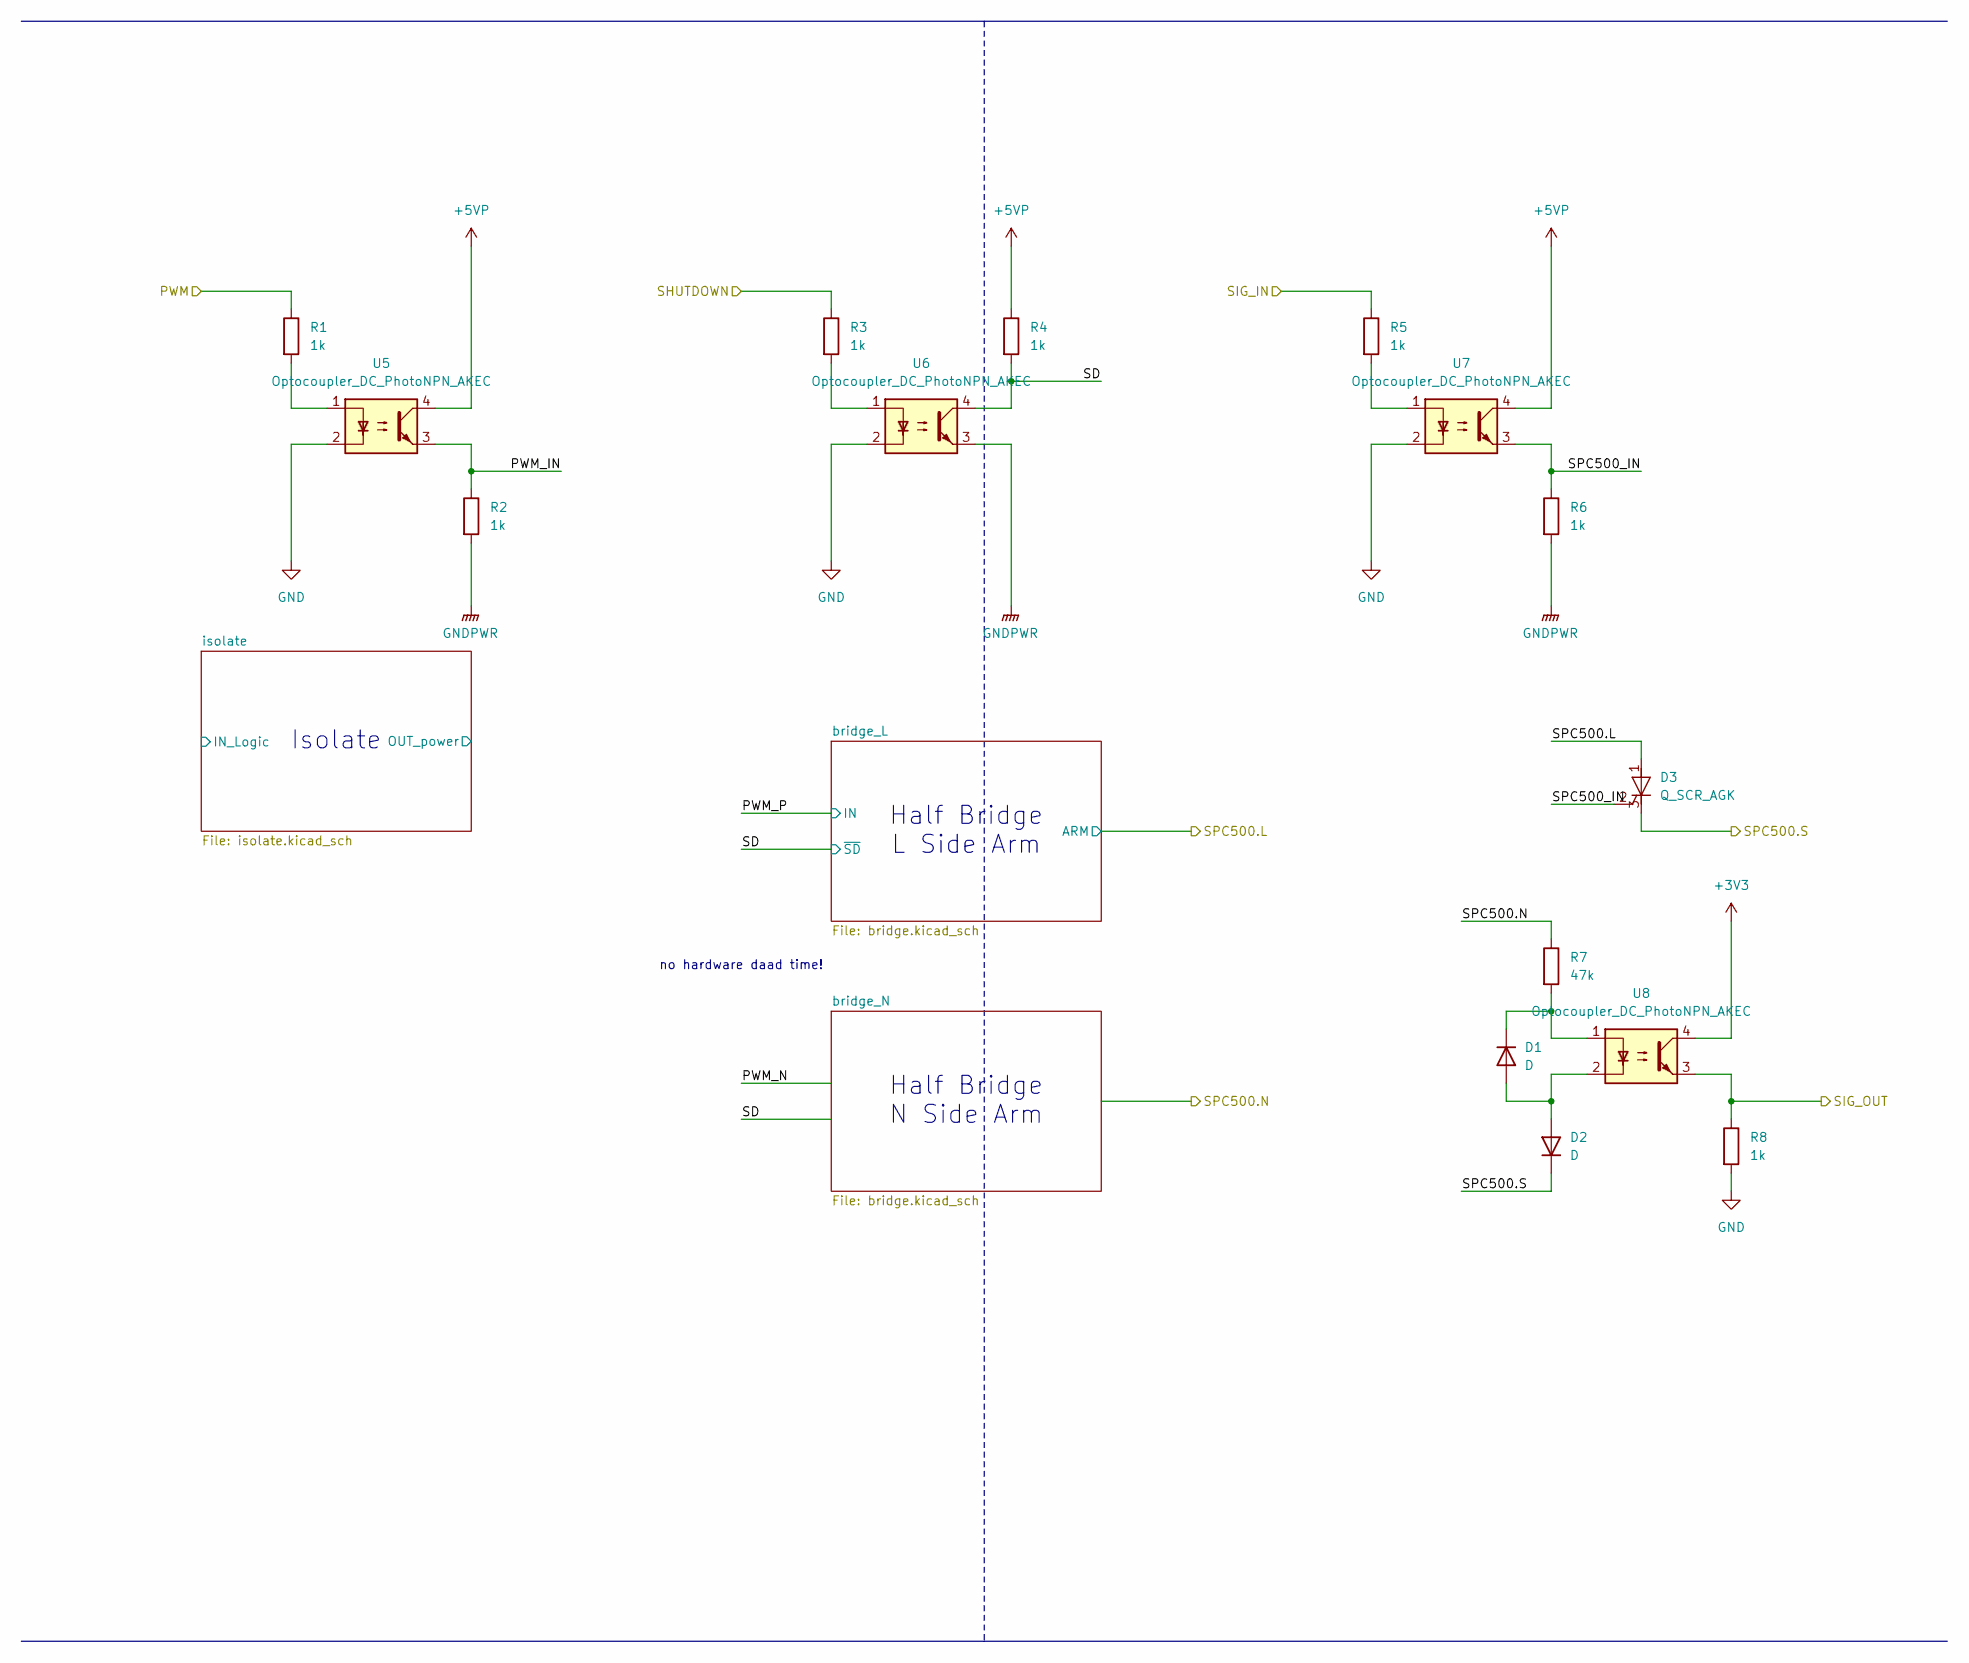
[picture p21: schematic spc500.kicad_sch]

Parts:
D1, D2: D
D3: Q_SCR_AGK
R1, R2, R3, R4, R5, R6, R8: 1k
R7: 47k
U5, U6, U7, U8: Optocoupler_DC_PhotoNPN_AKEC

Connections:
+3V3: U8.4
+5VP: R4.1, U5.4, U7.4
GND: R8.2, U5.2, U6.2, U7.2
GNDPWR: R2.2, R6.2, U6.3
unnamed: D1.1 (K), R7.2, U8.1
unnamed: D1.2 (A), D2.2 (A), U8.2
unnamed: R1.2, U5.1
unnamed: R3.2, U6.1
unnamed: R5.2, U7.1
PWM: R1.1
PWM_IN: R2.1, U5.3
SD: R4.2, U6.4
SHUTDOWN: R3.1
SIG_IN: R5.1
SIG_OUT: R8.1, U8.3
SPC500.L: D3.1 (A)
SPC500.N: R7.1
SPC500.S: D2.1 (K), D3.3 (K)
SPC500_IN: D3.2 (G), R6.1, U7.3

Notes on the sheet:
Half Bridge L Side Arm
Isolate
no hardware daad time!
Half Bridge N Side Arm
