EngAdriano/Aquabox_Final/hardware/aquabox_final/aquabox_final.kicad_pcb

## KiCad design test_spc500.kicad_sch

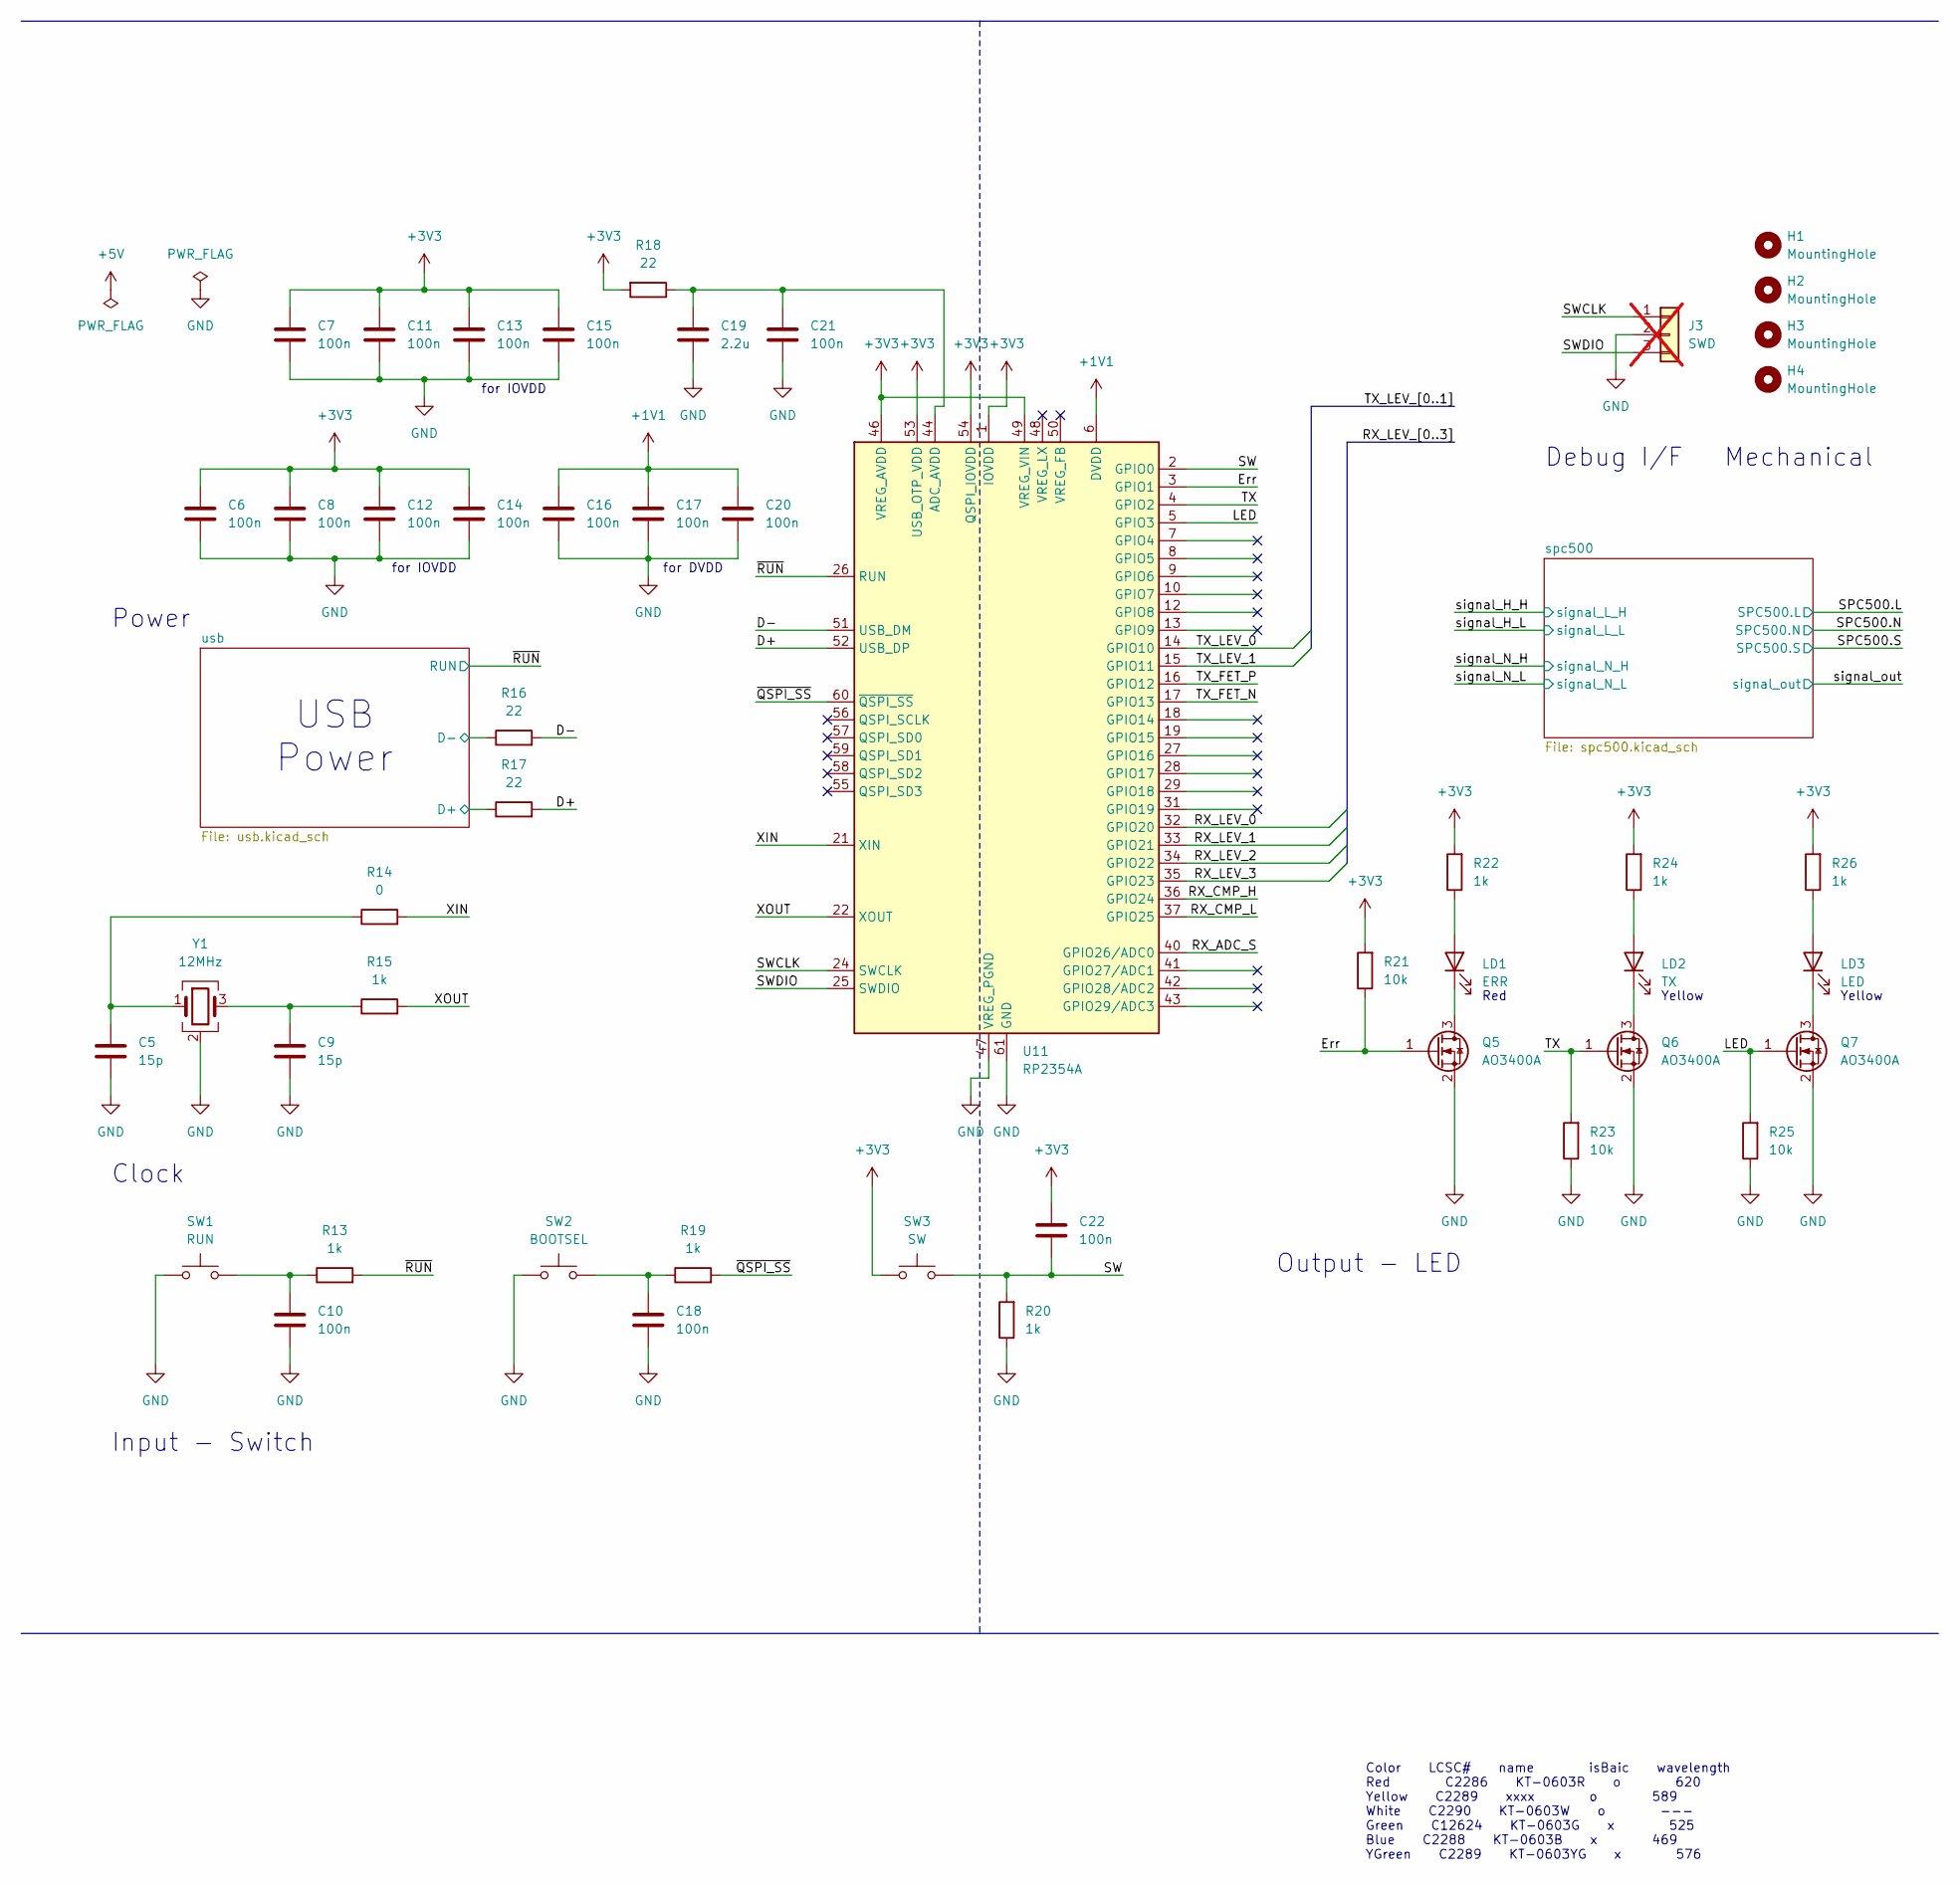
[picture p22: schematic test_spc500.kicad_sch]

Parts:
C5, C9: 15p; C_0603_1608Metric; LCSC C1644
C6, C7, C8, C10, C11, C12, C13, C14, C15, C16, C17, C18, C20, C21, C22: 100n; C_0402_1005Metric; LCSC C307331
C19: 2.2u; C_0603_1608Metric; LCSC C23630
H1, H2, H3, H4: MountingHole; MountingHole_3.2mm_M3; LCSC x
J3: SWD; PinHeader_1x03_P2.54mm_Vertical; LCSC x; not fitted
LD1: ERR; LED_0603_1608Metric; LCSC C2286
LD2: TX; LED_0603_1608Metric; LCSC C2289
LD3: LED; LED_0603_1608Metric; LCSC C2289
Q5, Q6, Q7: AO3400A; SOT-23; LCSC C20917
R13, R15, R19, R20, R22, R24, R26: 1k; R_0603_1608Metric; LCSC C21190
R14: 0; R_0603_1608Metric; LCSC C21189
R16, R17, R18: 22; R_0603_1608Metric; LCSC C23345
R21, R23, R25: 10k; R_0603_1608Metric; LCSC C21190
SW1: RUN; SW_Push_SPST_NO_Alps_SKRK; LCSC C720477
SW2: BOOTSEL; SW_Push_SPST_NO_Alps_SKRK; LCSC C720477
SW3: SW; SW_Push_SPST_NO_Alps_SKRK; LCSC C720477
U11: RP2354A; QFN-60-1EP_7x7mm_P0.4mm_EP3.4x3.4mm; LCSC C41378174
Y1: 12MHz; Crystal_SMD_3225-4Pin_3.2x2.5mm; LCSC C9002

Connections:
+1V1: C16.1, C17.1, C20.1, U11.6 (DVDD), U11.23 (DVDD), U11.39 (DVDD)
+3V3: C6.1, C7.1, C8.1, C11.1, C12.1, C13.1, C14.1, C15.1, C22.1, R18.2, R21.2, R22.2, R24.2, R26.2, SW3.1, U11.1 (IOVDD), U11.11 (IOVDD), U11.20 (IOVDD), U11.30 (IOVDD), U11.38 (IOVDD), U11.45 (IOVDD), U11.46 (VREG_AVDD), U11.49 (VREG_VIN), U11.53 (USB_OTP_VDD), U11.54 (QSPI_IOVDD)
D+: R17.1, R17.2, U11.52 (USB_DP)
D-: R16.1, R16.2, U11.51 (USB_DM)
Err: Q5.1 (G), R21.1, U11.3 (GPIO1)
GND: C5.2, C6.2, C7.2, C8.2, C9.2, C10.2, C11.2, C12.2, C13.2, C14.2, C15.2, C16.2, C17.2, C18.2, C19.2, C20.2, C21.2, J3.2, Q5.2 (S), Q6.2 (S), Q7.2 (S), R20.1, R23.1, R25.1, SW1.1, SW2.1, U11.47 (VREG_PGND), U11.61 (GND), Y1.2 (G), Y1.4 (G)
LED: Q7.1 (G), R25.2, U11.5 (GPIO3)
unnamed: C5.1, R14.1, Y1.1
unnamed: C9.1, R15.1, Y1.3
unnamed: C10.1, R13.1, SW1.2
unnamed: C18.1, R19.1, SW2.2
unnamed: C19.1, C21.1, R18.1, U11.44 (ADC_AVDD)
unnamed: LD1.1 (K), Q5.3 (D)
unnamed: LD1.2 (A), R22.1
unnamed: LD2.1 (K), Q6.3 (D)
unnamed: LD2.2 (A), R24.1
unnamed: LD3.1 (K), Q7.3 (D)
unnamed: LD3.2 (A), R26.1
RX_ADC_S: U11.40 (GPIO26/ADC0)
RX_CMP_H: U11.36 (GPIO24)
RX_CMP_L: U11.37 (GPIO25)
RX_LEV_0: U11.32 (GPIO20)
RX_LEV_1: U11.33 (GPIO21)
RX_LEV_2: U11.34 (GPIO22)
RX_LEV_3: U11.35 (GPIO23)
SW: C22.2, R20.2, SW3.2, U11.2 (GPIO0)
SWCLK: J3.1, U11.24 (SWCLK)
SWDIO: J3.3, U11.25 (SWDIO)
TX: Q6.1 (G), R23.2, U11.4 (GPIO2)
TX_FET_N: U11.17 (GPIO13)
TX_FET_P: U11.16 (GPIO12)
TX_LEV_0: U11.14 (GPIO10)
TX_LEV_1: U11.15 (GPIO11)
XIN: R14.2, U11.21 (XIN)
XOUT: R15.2, U11.22 (XOUT)
~QSPI_SS: R19.2, U11.60 (~QSPI_SS)
~RUN: R13.2, U11.26 (RUN)

Notes on the sheet:
for DVDD
Power
Yellow
Output - LED
Debug I/F
Color LCSC# name isBaic wavelength Red C2286 KT-0603R o 620 Yellow C2289 xxxx o 589 White C2290 KT-0603W o --- Green C12624 KT-0603G x 525 Blue C2288 KT-0603B x 469 YGreen C2289 KT-0603YG x 576
Clock
for IOVDD
Red
Mechanical
Input - Switch
USB Power
