EngAdriano/Aquabox_Final/hardware/aquabox_final/aquabox_final.kicad_pcb

## KiCad design usb.kicad_sch

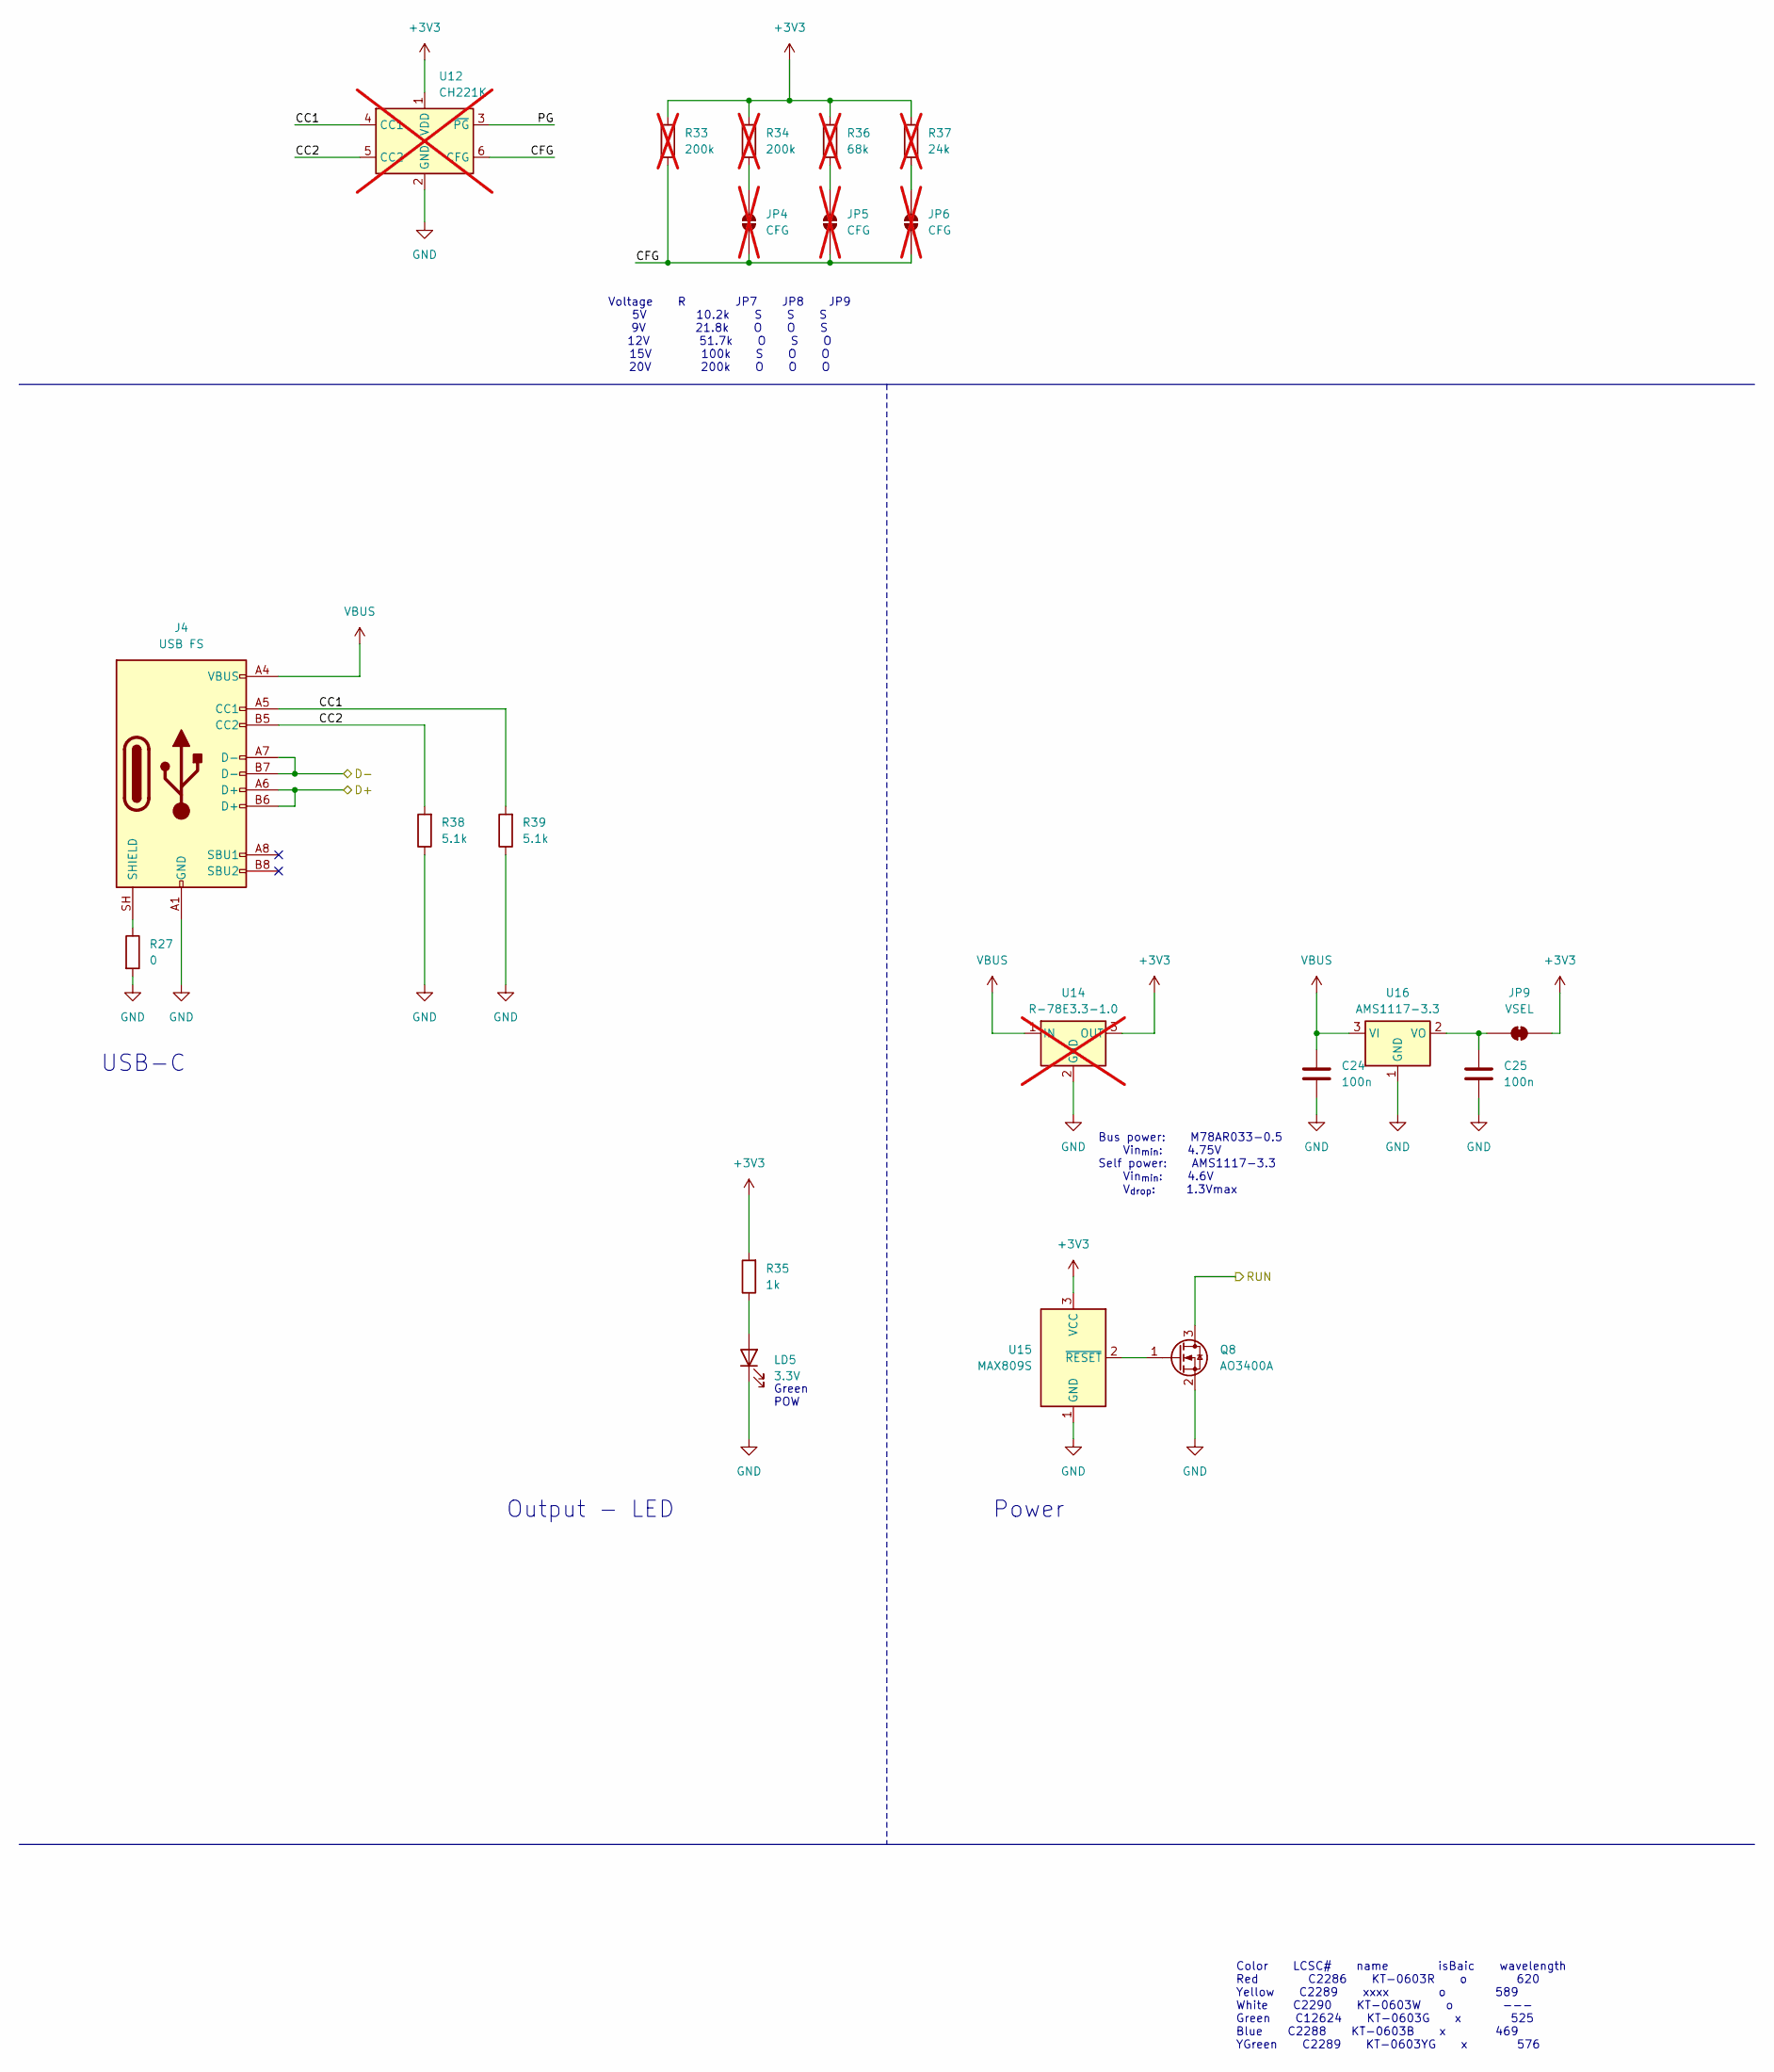
[picture p23: schematic usb.kicad_sch]

Parts:
C24, C25: 100n; C_0402_1005Metric; LCSC C307331
J4: USB FS; USB_C_Receptacle_GCT_USB4105-xx-A_16P_TopMnt_Horizontal; LCSC C5184243
JP4, JP5, JP6: CFG; SolderJumper-2_P1.3mm_Open_RoundedPad1.0x1.5mm; LCSC x; not fitted
JP9: VSEL; SolderJumper-2_P1.3mm_Open_RoundedPad1.0x1.5mm; LCSC x
LD5: 3.3V; LED_0603_1608Metric; LCSC C12624
Q8: AO3400A; SOT-23; LCSC C20917
R27: 0; R_0603_1608Metric; LCSC C21189
R33, R34: 200k; R_0603_1608Metric; LCSC C25811; not fitted
R35: 1k; R_0603_1608Metric; LCSC C21190
R36: 68k; R_0603_1608Metric; LCSC C23231; not fitted
R37: 24k; R_0603_1608Metric; LCSC C23352; not fitted
R38, R39: 5.1k; R_0603_1608Metric; LCSC C23186
U12: CH221K; SOT-23-6; LCSC C5125736; not fitted
U14: R-78E3.3-1.0; Converter_DCDC_RECOM_R-78E-0.5_THT; LCSC C18212316; not fitted
U15: MAX809S; SOT-23; LCSC C347371
U16: AMS1117-3.3; SOT-223-3_TabPin2; LCSC C6186

Connections:
+3V3: JP9.2 (B), R33.1, R34.1, R35.2, R36.1, R37.1, U12.1 (VDD), U14.3 (OUT), U15.3 (VCC)
CC1: J4.A5 (CC1), R39.2, U12.4 (CC1)
CC2: J4.B5 (CC2), R38.2, U12.5 (CC2)
CFG: JP4.1 (A), JP5.1 (A), JP6.1 (A), R33.2, U12.6 (CFG)
D+: J4.A6 (D+), J4.B6 (D+)
D-: J4.A7 (D-), J4.B7 (D-)
GND: C24.2, C25.2, J4.A1 (GND), J4.A12 (GND), J4.B1 (GND), J4.B12 (GND), LD5.1 (K), Q8.2 (S), R27.2, R38.1, R39.1, U12.2 (GND), U14.2 (GND), U15.1 (GND), U16.1 (GND)
unnamed: C25.1, JP9.1 (A), U16.2 (VO)
unnamed: J4.SH (SHIELD), R27.1
unnamed: JP4.2 (B), R34.2
unnamed: JP5.2 (B), R36.2
unnamed: JP6.2 (B), R37.2
unnamed: LD5.2 (A), R35.1
unnamed: Q8.1 (G), U15.2 (~RESET)
PG: U12.3 (~PG)
RUN: Q8.3 (D)
VBUS: C24.1, J4.A4 (VBUS), J4.A9 (VBUS), J4.B4 (VBUS), J4.B9 (VBUS), U14.1 (IN), U16.3 (VI)

Notes on the sheet:
Power
Green POW
USB-C
Output - LED
Voltage R JP7 JP8 JP9 5V 10.2k S S S 9V 21.8k O O S 12V 51.7k O S O 15V 100k S O O 20V 200k O O O
Bus power: M78AR033-0.5 Vin_{min}: 4.75V Self power: AMS1117-3.3 Vin_{min}: 4.6V V_{drop}: 1.3Vmax
Color LCSC# name isBaic wavelength Red C2286 KT-0603R o 620 Yellow C2289 xxxx o 589 White C2290 KT-0603W o --- Green C12624 KT-0603G x 525 Blue C2288 KT-0603B x 469 YGreen C2289 KT-0603YG x 576
