EngAdriano/Aquabox_Final/(commit log)

2026-02-19 Atualização
    [Aquabox_v1.0_BOM_Detalhada.xlsx, Aquabox_v1.0_BOM_Industrial_Fabricacao.xlsx]
2026-05-27 Início do projeto Aquabox Final
    [aquabox_final.kicad_pcb, aquabox_final.kicad_sch]
2026-05-29 Inicio do esquemático
    [Aquabox_BOM_RevA2.xlsx, Aquabox_Pinagem_ESP32S3.xlsx, Aquabox_Pinagem_RevA2.xlsx, Display.kicad_sch, ESP32-S3-DEVKITC-1-N16R8V.step, aquabox_final.kicad_sch, esp32_s3.kicad_sch, expansion.kicad_sch]
2026-06-02 Desenvolvimento da fonte de alimentação.
    [power.kicad_sch]
2026-06-03 Conector do display e teclado
    [Conect_2x10.step, esp32_s3.kicad_sch, inputs.kicad_sch]
2026-06-03 Acionamento da bom e solenóides
    [aquabox_final.kicad_sch, esp32_s3.kicad_sch, inputs.kicad_sch, power.kicad_sch, solenoids.kicad_sch]
2026-06-08 Implementação do RTC
    [aquabox_final.kicad_sch, esp32_s3.kicad_sch, inputs.kicad_sch, power.kicad_sch, rtc_sd.kicad_sch, solenoids.kicad_sch]
2026-07-04 Acionamento do mosfet
    [testeMosfet [20260622, 11-18-56].pdsprj, testeMosfet [20260702, 09-51-27].pdsprj, testeMosfet [20260702, 09-51-28].pdsprj, testeMosfet [20260702, 09-51-29].pdsprj, testeMosfet [20260702, 09-55-35].pdsprj, testeMosfet [20260702, 09-57-04].pdsprj, testeMosfet [20260702, 09-57-44].pdsprj, testeMosfet [20260702, 10-01-05].pdsprj]
2026-07-29 Esquemático Aquabox III
    [Interfaces.kicad_sch, Lista_Componentes.xlsx, aquabox_final.csv, aquabox_final.kicad_sch, inputs.kicad_sch, solenoids.kicad_sch]
2026-08-21 Pinagem ESP32_S3
2026-09-02 Atualização de planejamento
    [Pinagem_Aquabox.xlsx]
2026-09-12 Organização em pastas.
    Organização em pastas para facilitar o desenvolvimento e a manutenção do projeto.
2026-09-13 Testes para o display e os botões.
